TuanAnhPham8459/SmartFarm/system/ceng355wk05hardwareconnstatus.md

# CENG 355 Week 05 Hardware Connectivity Status
## Weekly checks for every student:
- Present in person in a safe manner for the duration of the class: glasses, no food/drink, etc.
- Hardware and any other project equipment present.
## Last week
- Feedback:   
## This week
- Working on status update [wk05connectivity.md](wk05connectivity.md) by student D on behalf of the group due the night before 10am Sunday.
- Mention which of your sensors/effectors have built in I2C bus pull-up resistors and whether they can be easily disconnected.
- Insert Executive Summary from proposal into [ceng355report.md](ceng355report.md).
- Preparing App preferably on an actual phone for the demo, test with firebase.
- Test your sensor demos, we'll be working on a couple of projects that require updated PCBs in KiCad.
## Interim Demonstration week
Next week if your section falls on a Monday
