TuanAnhPham8459/SmartFarm/system/wk02hardware.md

# Hardware Status Update
## Recent and current progress
- **VEML7700 (1/A)**: Verified the sensor's functions and tested the other options/output it offers.
- **OPT4048 (2/B)**: Tested, working as expected.
- **SSD1305 (3/C)**: Tested, working as expected.
- **SGP40 (4/D)**: Continued diagnosing the inconsistency of this sensor.
- **ID-12LA (5/D)**: Tested, working as expected.
## Problems and hyperlinks/urls to potential solutions
- SGP40: The Raspberry Pi sometimes fails to recognize the sensor even after the recommended warm-up period.
- VEML7700: The settings function returns an error when used  - [Check official library document to find updated function](https://docs.circuitpython.org/projects/veml7700/en/latest/api.html)
## Financial
### Expenditures since previous report
Safety Glasses (4 pairs) - 27.07$
### Planned future expenses
New sensors are proposed but no costs have been incurred at this moment.
