TuanAnhPham8459/SmartFarm/system/355criticalpath2026sep-dec.md

# Welcome to [CENG 355 – Computer Systems Project](https://humber.ca/transferoptions/course-outlines/outline.html?code=CENG%20355)
https://www.humber.ca/careeradvancement/careerconnect-job-search-site   
https://humber.ca/advancementandalumni/scholarships-awards.html   
https://github.com/PrototypeZone/ceng317/blob/main/README.md   

# Critical Path

## Fall 2026 Class Schedule (Tentative)

|Week|B |A |Topics/Assignment | Due % |
|----|---|---|---|---|
| |2026-09-07|2026-09-07|Monday Public Holiday (Labour Day) - College Closed | |
|1 |2026-09-10|2026-09-11|Course Introduction and Schedule, [Group Setup, Group Project Proposal](ceng355wk01proposal.md) |1 First Class Sheet  |
|2 |2026-09-17|2026-09-18|Hardware status by student A, firmware, KiCad |4 Proposal |
|3 |2026-09-24|2026-09-25|Mobile status report by student B, |5 Hardware Status |
|4 |2026-10-01|2026-10-02|Database status report by student C, declaration of authorship, laser cutting Inkscape |5 Mobile Status |
|5 |2026-10-08|2026-10-09|Hardware connectivity status report by student D |5 Database Status |
| |2026-10-12|2026-10-12|Monday Public Holiday (Thanksgiving Day) - College Closed | |
|6 |2026-10-15|2026-10-16|Preliminary demos, troubleshooting |5 Connectivity Status|
|7 |2026-10-22|2026-10-23|Hardware/Firmware, Database, and Mobile App Independent Demonstration, all parts should work independently|10 Demo |
| |2026-10-29|2026-10-30|*Reading Week, No Class Scheduled* | |
|8 |2026-11-05|2026-11-06|Poster Draft, unit and production testing (Nov 6 Midterm Grades Due) |5 |
|9 |2026-11-12|2026-11-13|Enclosure and integration status |5 |
|10  |2026-11-19|2026-11-20|Presentation Slides due and poster updates |5 |
|11  |2026-11-26|2026-11-27|Troubleshooting, preliminary demonstrations |5 |
|12  |2026-12-03|2026-12-04|, Project Demonstration Group Final Presentation |5, 15 |
|~15~|2026-12-04|2026-12-04|Capstone Showcase (Mandatory attendance, your other professors will be advised to not schedule conflicting evaluations|20 |
| | | |The 2026 Winter Capstone Expo will take place on Friday, December 4th, from 1:00 to 4:00 p.m. | |
|13  |2026-12-10|2026-12-11|Report Checklist |5 |
|14  |2026-12-17|2026-12-18|Checklist feedback | |
| | | | |**100** |

• Students are reminded that they are working with prototypes and that
prototypes are not to be left powered unattended despite the connectivity that
they develop.

• The small physical prototypes that you build are to be safe enough to be
worked on at home and small enough to be carried with you.

• In alignment with the space below the tray in the Humber North Campus
Electronics Parts kit the overall project maximum dimensions are

12 13/16" x 5 ¹/₂" x 2 ³/₄" = 32.5cm x 14cm x 7cm.

• Keeping safety and Z462 in mind, the highest AC voltage that is to be used is
16Vrms from a wall adapter from which +/- 15V or as high as 45 VDC can be
obtained. Maximum power consumption is to be 20 Watts.

• If your PCB doesn’t work or you need to switch sensors/effectors, it is
recommended that you use the SparkFun Qwiic system:
[https://www.sparkfun.com/products/15945](https://www.sparkfun.com/products/15945)

• A passing grade for this course is 50%. To get an overall passing grade in
this course, students must independently pass the Reporting and the Project
Demonstration portions of the course. If one or more of these sections is less
than 50% then the final grade for the course will be the lower of the two marks.

• Late Submission penalty: 10% penalty per day for late submissions.

• Classroom attendance is mandatory for grading, the student will get zero for
the submission if they missed the session for the corresponding week.
