TuanAnhPham8459/SmartFarm/system/ceng355wk06midtermdemo.md

# CENG 355 Week 06

## Weekly checks for every student:
- [ ] Present in person in a safe manner for the duration of the class: glasses, no food/drink, etc.
- [ ] Hardware and any other project equipment present.

## Last week
- Feedback:   

## This week
- Preliminary Demos (still have next week unless your section falls on a Monday)   

## Demo
- Hardware/Firmware, Database, and Mobile App Independent Demonstration, all parts should work independently.
- [ ] PCB
- [ ] Case
- [ ] App 
- [ ] Database 
- [ ] Sensor/effector A value read/commanded  
- [ ] Sensor/effector B value read/commanded
- [ ] Sensor/effector C value read/commanded
- [ ] Sensor/effector D value read/commanded

## Next week, depending on the semester, could be a holiday (college closed) followed by reading week (college open) the subsequent week
- Some groups have priority work to do with their PCBs, KiCad.
- Many groups should continue to incrementally improve their case.
- All groups have integration work to do.
