TuanAnhPham8459/SmartFarm/system/wk03mobile.md

# Mobile Status Update
## Recent and current progress
- Merging code and connecting the sensors.
- How the app works: The app monitors sensor readings through a Firebase database and sends alerts when issues are detected. It also supports multiple farms under a single account, allowing users to monitor multiple farms from one account.
 
## Problems and hyperlinks/urls to potential solutions
OPT4048:
- Library was not set up - [Check library document on GitHub to find updated function](https://github.com/sparkfun/qwiic_opt4048_py)
- Missing module - [Check module document on GitHub to find updated function](https://github.com/adafruit/Adafruit_CircuitPython_OPT4048)
- Troubleshoot the sensor; replace it if the issue cannot be resolved within the available timeframe.

SSD1305 OLED:
- Environment was not set up - [Check official library document to find updated installation and dependencies](https://docs.circuitpython.org/projects/ssd1305/en/latest)

## Financial
### Expenditures since previous report
None.
### Planned future expenses
New sensors are proposed, but no costs have been incurred at this moment.
