TuanAnhPham8459/SmartFarm/system/wk04database.md

# Database Status Update
## Recent and current progress
* Case was redesigned base on instructor's feedback.
* New sensor was added to the scope to replace bad one: Air quality sensor [BME688](https://www.amazon.ca/Environmental-Multi-Function-Capability-Temperature-Atmospheric/dp/B0GF231DPN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).
* Currently the database is fetching realtime sensor data, alert, device's config, feedback, and user account. Further discussion about what should be next to be sent to database is ongoing.
* Fetches sensor logs with configurable limits and sorts by timestamp descending.
* Links database documents directly to authenticated user IDs and email/password or Google sign-in credentials.
* Leverages Firestore's built-in offline persistence and cache metadata checks. Caches user profile data locally so the app remains usable when offline.
## Problems and hyperlinks/urls to potential solutions
Daisy chained sensors will not work if keeping the SenseHat. Since we use all kind of sensors, SenseHat is redundant and can be removed.
## Financial
### Expenditures since previous report
New air sensor BME688: 25$
### Planned future expenses
Bolt and nut
