TuanAnhPham8459/SmartFarm/hardware/Final Report - Tuan Anh Pham.docx

Hardware Report / Build Instructions

Multithreaded Raspberry Pi Monitoring System

SSD1305 OLED • Sense HAT • GPIO17 Transistor-Driven LED

Report item | Information
Platform | Raspberry Pi 4 running Raspberry Pi OS
Application | Real-time system, environment, orientation, and network monitoring
Target reader | Computer Engineering Technology student reproducing the project
Prepared for | CENG317 Hardware Project
Date | August 2026

Document purpose

This document provides the hardware, platform configuration, assembly, software installation, operation, and testing procedures required to reproduce the project. All GPIO changes must be performed while the Raspberry Pi is shut down and disconnected from power.

# Table of Contents

Section | Contents
1.0 | Introduction: Raspberry Pi Platform and Existing Functionality
1.1 | Scope and expected result
1.2 | Safety and handling requirements
2.0 | Added Functionality and System Architecture
2.1 | Sensor/Effector Purchase and Preparation
2.1.1 | Required tools
2.2 | PCB Design and Soldering
2.2.1 | Circuit function
2.2.2 | PCB inspection before soldering
2.2.3 | Recommended soldering order
2.2.4 | Unpowered electrical tests
2.3 | Case Design and Assembly
2.3.1 | Mechanical arrangement
2.3.2 | Assembly sequence
2.3.3 | Signal assignment
2.4 | Firmware Development and Use
2.4.1–2.4.3 | Platform, I²C, and Python environment configuration
2.4.4–2.4.8 | Application architecture, device operation, and execution
3.0 | Testing and Results
3.1–3.6 | Test sequence, standalone tests, results, troubleshooting, and acceptance
4.0 | References
Appendix A | Key Configuration Values
Appendix B | Command Summary

# 1.0 Introduction: Raspberry Pi Platform and Existing Functionality

The project is based on a Raspberry Pi 4 single-board computer using the Broadcom system-on-chip platform and the 40-pin general-purpose input/output (GPIO) header. Raspberry Pi OS provides Linux process management, device drivers, I²C communication, network services, thermal information, and Python support. These built-in capabilities make the platform suitable for combining system monitoring with environmental sensing and physical status indication.

The completed device monitors processor utilization, memory utilization, processor temperature, system uptime, local Internet Protocol (IP) address, external network availability, ambient temperature, relative humidity, atmospheric pressure, pitch, roll, and yaw. A 128 × 32 SSD1305 organic light-emitting diode (OLED) presents detailed values. A Raspberry Pi Sense HAT supplies environmental and orientation measurements, joystick input, and an 8 × 8 red-green-blue (RGB) matrix. A custom printed circuit board (PCB) uses GPIO17 and a 2N3904 NPN transistor to drive an external light-emitting diode (LED).

Three worker threads operate concurrently. The OLED thread formats and refreshes status pages. The Sense HAT thread reads sensors, receives joystick events, and controls the RGB matrix. The PCB LED thread toggles GPIO17 independently. A main thread starts the workers, provides a common stop event, and performs orderly shutdown. A locked shared-state object prevents inconsistent sensor values while the Sense HAT thread writes data and the OLED thread reads it.

## 1.1 Scope and expected result

- Configure Raspberry Pi OS, I²C, Python, and the project virtual environment.
- Assemble the Sense HAT, SSD1305 OLED, and transistor-driven LED PCB without GPIO conflicts or shorts.
- Install and run the multithreaded Python application.
- Verify every hardware device independently before running the combined application.
- Demonstrate concurrent operation, joystick control, sensor acquisition, and safe cleanup.

The procedure assumes a Raspberry Pi 4 with a working microSD card, network connection, display or Secure Shell (SSH) access, and a regulated USB-C power supply rated appropriately for the Raspberry Pi 4 and attached accessories.

## 1.2 Safety and handling requirements

WARNING: Never attach, remove, or reposition a HAT, Bonnet, PCB, jumper wire, or GPIO connector while the Raspberry Pi is powered. A one-pin offset or partially seated connector can short 3.3 V, 5 V, and ground.

- Shut down with sudo shutdown -h now, wait for activity to stop, and unplug USB-C power before hardware changes.
- Use nylon standoffs. Conductive spacers or screws must not contact solder joints, pads, or traces.
- Seat every 40-pin connector fully and evenly. Spacers must support the board without pulling the connector upward.
- Use 3.3 V GPIO logic. No Raspberry Pi GPIO pin is 5 V tolerant.
- Drive the external LED through the PCB transistor circuit; do not connect a high-current load directly to GPIO17.

# 2.0 Added Functionality and System Architecture

The added hardware extends the Raspberry Pi from a general-purpose Linux computer into a self-contained monitoring station. The functional allocation is shown below.

Subsystem | Primary function | Interface/resource
SSD1305 OLED | Displays system, environmental, orientation, and network pages | I²C bus 1; address 0x3C; GPIO4 reset
Sense HAT V2 | Measures environment and orientation; receives joystick input; shows status icon | 40-pin HAT connection; I²C and framebuffer/input drivers
Custom PCB LED driver | Provides an external one-second status blink | GPIO17, physical pin 11, through 2N3904 transistor
Python application | Coordinates devices using separate worker threads | threading.Event, threading.Lock, shared state

## 2.1 Sensor/Effector Purchase and Preparation

Table 1 lists the required materials. Equivalent parts may be substituted only when voltage, interface, dimensions, and pin functions are verified against the replacement datasheet.

Qty. | Item | Specification or selection requirement
1 | Raspberry Pi 4 | Any memory size; 40-pin GPIO header; Raspberry Pi OS support
1 | microSD card | 16 GB minimum; reliable Class 10 or better recommended
1 | USB-C power supply | Regulated supply suitable for Raspberry Pi 4 and accessories
1 | Adafruit 2.23-inch OLED Bonnet | 128 × 32 monochrome OLED; SSD1305; I²C address 0x3C; GPIO4 reset
1 | Raspberry Pi Sense HAT V2 | Environmental sensors, inertial measurement unit, joystick, 8 × 8 RGB matrix
1 | Custom LED PCB | 2N3904 NPN transistor driver connected to GPIO17
1 | External LED and resistor | Installed according to the custom PCB schematic and LED polarity
1 | 40-pin stacking header or GPIO duplicator | Must allow both boards to connect fully without mechanical interference
4+ | Nylon standoffs, screws, and nuts | Correct height for the board stack; nonconductive
As needed | Insulated jumper wires/connectors | Short, secure connections; labelled for 3.3 V, GND, SDA, SCL, and reset

### 2.1.1 Required tools

- Digital multimeter with direct-current voltage, resistance, and continuity modes.
- Temperature-controlled soldering iron, solder, flux, tip cleaner, and desoldering braid or pump.
- Small side cutters, needle-nose pliers, wire stripper, and precision screwdriver set.
- ESD-safe work surface or grounded antistatic precautions.
- Computer or Raspberry Pi terminal for operating-system imaging, package installation, and testing.

## 2.2 PCB Design and Soldering

### 2.2.1 Circuit function

GPIO17 supplies only the transistor control signal. When GPIO17 is HIGH, base current turns the 2N3904 on and current flows through the LED load path. When GPIO17 is LOW, the transistor turns off and the LED current stops. The base resistor, LED current-limiting resistor, transistor pinout, supply rail, and common ground must match the project schematic.

Pinout check: The 2N3904 emitter, base, and collector order must be verified for the exact manufacturer part. Do not rely only on the flat side of the package because lead ordering can vary by package and vendor.

### 2.2.2 PCB inspection before soldering

Step 1 — Identify pin 1 and connector orientation

Locate physical pin 1 on the Raspberry Pi header footprint and confirm that the footprint was not mirrored when placed on the underside of the PCB. Mark pin 1 temporarily with removable tape.

Step 2 — Trace the required nets

Using the schematic and PCB viewer, verify 3.3 V, ground, SDA, SCL, GPIO4 reset, and GPIO17. Confirm that the OLED VCC connector is connected to Raspberry Pi physical pin 1 or 17 and that OLED ground connects to a valid ground pin.

Step 3 — Check clearances

Confirm that mounting holes, connector bodies, solder joints, and standoffs do not interfere with the Sense HAT or OLED. Confirm access to the joystick and visibility of both displays.

### 2.2.3 Recommended soldering order

Step 1 — Install low-profile resistors

Insert and solder the transistor base resistor and LED current-limiting resistor. Trim leads close to the solder joint without damaging the pad.

Step 2 — Install the 2N3904

Orient the transistor according to the verified emitter-base-collector mapping. Leave a small gap between the body and PCB to prevent mechanical stress.

Step 3 — Install the LED

Match the LED anode and cathode to the PCB markings. The cathode is normally identified by the shorter lead and the flat edge of the LED package.

Step 4 — Install headers and connectors

Hold headers perpendicular to the PCB while soldering one corner pin. Recheck alignment before soldering the remaining pins. Avoid excess solder that could bridge adjacent header pins.

Step 5 — Clean and inspect

Remove flux residue when required by the flux type. Inspect every joint under bright light for bridges, insufficient wetting, cracked rings, or untrimmed leads.

### 2.2.4 Unpowered electrical tests

Disconnect the Raspberry Pi and all power sources. Use continuity or resistance mode and record the results before assembly.

Measurement | Expected result | Action if incorrect
PCB pin 1/17 to OLED VCC | Continuity; near-zero wiring resistance | Repair missing trace, solder joint, or connector mapping
PCB ground to OLED GND | Continuity | Repair ground connection
GPIO2 to OLED SDA | Continuity | Correct SDA routing
GPIO3 to OLED SCL | Continuity | Correct SCL routing
GPIO4 to OLED reset | Continuity | Add or repair reset connection
GPIO17 to transistor base resistor | Continuity through the intended route | Correct GPIO17 trace or solder joint
3.3 V to ground | No steady near-zero resistance | Locate short before applying power
5 V to ground | No steady near-zero resistance | Locate short before applying power

## 2.3 Case Design and Assembly

### 2.3.1 Mechanical arrangement

Both the Sense HAT and OLED Bonnet require Raspberry Pi signals, but both cannot occupy the same physical header position without a stacking arrangement. Use a proper 40-pin stacking header, GPIO duplicator, or ribbon-cable breakout. The connector must be fully seated; taller nylon spacers must not be used to hold a connector partly disengaged.

Layer | Assembly requirement
Top/user-access layer | Sense HAT joystick and RGB matrix must remain unobstructed.
OLED location | Screen must remain visible; GPIO4 reset and I²C signals must be routed correctly.
Custom PCB | No exposed conductor may touch either HAT; GPIO17 LED circuit must remain accessible.
Raspberry Pi 4 | USB-C power, HDMI, network, and ventilation openings must remain accessible.
Standoffs | Use nylon hardware of matching height at all supported corners.

### 2.3.2 Assembly sequence

Step 1 — Shut down and isolate power

Run sudo shutdown -h now. Wait until storage activity stops, then disconnect the USB-C supply and every externally powered cable.

Step 2 — Install Raspberry Pi standoffs

Fasten nylon standoffs without overtightening. Confirm that the board remains flat and that no fastener contacts components.

Step 3 — Connect the custom PCB

Align physical pin 1, engage both GPIO rows evenly, and press only on the connector area. Confirm that the board is level and fully seated.

Step 4 — Connect the OLED

Route 3.3 V, ground, SDA, SCL, and GPIO4 reset. Follow signal labels rather than wire colour because jumper colours are not standardized.

Step 5 — Connect the Sense HAT

Align the complete 40-pin connector with the duplicator or stacking header. Confirm that neither row is offset and that the joystick remains accessible.

Step 6 — Perform final inspection

Check for bent pins, loose wires, metal contact, reversed connectors, and insufficient clearance. Verify that the stack cannot rock or pull upward from the header.

Step 7 — Apply power

Connect the regulated Raspberry Pi power supply. If all LEDs immediately go dark, power cycles repeatedly, a component heats rapidly, or an unusual smell is detected, disconnect power and repeat short-circuit tests.

### 2.3.3 Signal assignment

Signal/device | BCM GPIO | Physical pin | Purpose
3.3 V | — | 1 or 17 | OLED/logic supply as required by the assembly
Ground | — | 6 or another GND | Common electrical reference
I²C SDA | GPIO2 | 3 | OLED and I²C sensor data
I²C SCL | GPIO3 | 5 | OLED and I²C sensor clock
OLED reset | GPIO4 | 7 | Places SSD1305 controller in a known startup state
PCB LED control | GPIO17 | 11 | Drives 2N3904 base circuit

## 2.4 Firmware Development and Use

### 2.4.1 Raspberry Pi OS preparation

Step 1 — Install Raspberry Pi OS

Use Raspberry Pi Imager to write Raspberry Pi OS to the microSD card. Configure the hostname, user account, network, locale, and SSH settings as required. Insert the card and boot the Raspberry Pi.

Step 2 — Update the operating system

Open a Linux terminal and update package information before installing hardware libraries.

sudo apt update

sudo apt full-upgrade -y

Step 3 — Enable I²C

Run the configuration utility, select Interface Options → I2C → Enable, finish, and reboot.

sudo raspi-config

sudo reboot

Step 4 — Install diagnostic and Python packages

Install the I²C scanner, virtual-environment support, Pillow, psutil, and official Sense HAT software.

sudo apt install -y i2c-tools python3-pip python3-venv python3-pil python3-psutil sense-hat

Step 5 — Reboot after Sense HAT installation

The reboot loads the required kernel drivers and device-tree configuration.

sudo reboot

### 2.4.2 Verify I²C hardware

After rebooting, scan bus 1. The OLED should normally appear at hexadecimal address 3c. Additional addresses may appear for the Sense HAT. An empty scan indicates a wiring, power, connector, or interface problem and must be corrected before running the application.

ls -l /dev/i2c-1

sudo i2cdetect -y 1

### 2.4.3 Create and configure the Python environment

A project-specific virtual environment prevents package conflicts. The commands below assume that the project folder is /home/pi/CENG317.

mkdir -p ~/CENG317

cd ~/CENG317

python3 -m venv oled-env

source oled-env/bin/activate

python -m pip install --upgrade pip setuptools wheel

python -m pip install adafruit-blinka adafruit-circuitpython-ssd1305 pillow psutil RPi.GPIO

The terminal prompt should begin with (oled-env). Verify all required imports before running the project:

python -c "import board, adafruit_ssd1305, psutil, RPi.GPIO; from PIL import Image; from sense_hat import SenseHat; print('Libraries ready')"

Thonny configuration: Shell commands such as cd and source must not be entered at the >>> Python prompt. In Thonny, select Tools → Options → Interpreter → Alternative Python 3 interpreter or virtual environment, then choose /home/pi/CENG317/oled-env/bin/python and restart the backend.

### 2.4.4 Multithreaded application structure

Copy dual_oled_sensehat_dashboard.py into ~/CENG317. The program allocates one owner thread per hardware subsystem. This separation prevents the one-second LED timing from blocking joystick events, sensor acquisition, or OLED refreshes.

oled_thread = threading.Thread(

target=oled_worker, args=(state, stop_event), name="OLED-Thread")

sense_thread = threading.Thread(

target=sense_hat_worker, args=(state, stop_event), name="SenseHAT-Thread")

pcb_led_thread = threading.Thread(

target=pcb_led_worker, args=(stop_event,), name="PCB-LED-Thread")

oled_thread.start()

sense_thread.start()

pcb_led_thread.start()

The Sense HAT thread writes environmental and orientation values to SharedState. The OLED thread reads the same values. A threading.Lock provides mutual exclusion so a complete set of readings is copied consistently.

with state.lock:

state.temperature = adjusted_temperature

state.humidity = humidity

state.pressure = pressure

with state.lock:

temperature = state.temperature

humidity = state.humidity

pressure = state.pressure

A threading.Event provides a shared shutdown signal. Ctrl+C sets the event; every thread leaves its loop, clears its hardware, and releases GPIO resources.

### 2.4.5 OLED operation

The OLED thread initializes a 128 × 32 SSD1305 at address 0x3C and uses GPIO4 for reset. Pillow creates a one-bit image in memory. The page title and two compact lines are drawn and transferred to the OLED buffer. Four pages rotate automatically:

- PI SYSTEM: CPU utilization, RAM utilization, processor temperature, and uptime.
- ENVIRONMENT: adjusted Sense HAT temperature, humidity, and pressure.
- ORIENTATION: pitch, roll, and yaw in degrees.
- NETWORK: local IP address and online/offline state.

oled = adafruit_ssd1305.SSD1305_I2C(

128, 32, i2c, addr=0x3C, reset=reset_pin)

image = Image.new("1", (128, 32))

oled.image(image)

oled.show()

### 2.4.6 Sense HAT and joystick operation

The Sense HAT thread reads temperature, humidity, pressure, and orientation approximately twice per second. Pitch represents front-to-back tilt, roll represents side-to-side tilt, and yaw represents rotation about the vertical axis. The RGB matrix displays a green check when the network test succeeds and a red X when it fails.

Joystick action | Application response
Right | Select next OLED page and disable automatic rotation
Left | Select previous OLED page and disable automatic rotation
Centre press | Toggle automatic page rotation
Up | Increase Sense HAT matrix brightness
Down | Decrease brightness; level zero clears the matrix

### 2.4.7 PCB LED operation

The LED worker configures BCM GPIO17 as an output and alternates HIGH and LOW once per second. stop_event.wait() is used instead of sleep(), allowing immediate interruption during shutdown. The cleanup block forces GPIO17 LOW before releasing the channel.

while not stop_event.is_set():

GPIO.output(PCB_LED_PIN, GPIO.HIGH)

if stop_event.wait(1.0):

break

GPIO.output(PCB_LED_PIN, GPIO.LOW)

if stop_event.wait(1.0):

break

### 2.4.8 Run and stop the program

cd ~/CENG317

source oled-env/bin/activate

python dual_oled_sensehat_dashboard.py

The terminal should report that all three threads started. Stop the application with Ctrl+C. Normal shutdown clears the OLED and Sense HAT matrix, turns the PCB LED off, cleans GPIO17, and joins all worker threads.

# 3.0 Testing and Results

## 3.1 Test sequence

Each subsystem must pass independently before the combined test. This isolates wiring and dependency problems and prevents one thread failure from being mistaken for a complete system failure.

Test | Procedure | Pass criterion
Power rail | Measure OLED VCC to GND after power-up. | Approximately 3.3 V; no rapid heating or power cycling.
I²C scan | Run sudo i2cdetect -y 1. | OLED appears at 0x3C; Sense HAT addresses also appear.
OLED standalone | Initialize SSD1305, fill the display, then show text. | Screen illuminates and displays stable text without stripes.
Sense HAT sensors | Print temperature, humidity, pressure, pitch, roll, and yaw. | Plausible values update; orientation changes when moved.
RGB matrix | Display red, green, and blue for two seconds each. | All matrix pixels show the requested colours.
Joystick | Press all five directions. | Correct direction events are received.
PCB LED | Run the GPIO17 blink worker. | External LED alternates on/off once per second.
Combined application | Run all three threads for at least two minutes. | OLED refreshes, joystick responds, matrix indicates network status, and LED blinks concurrently.
Shutdown | Press Ctrl+C. | Displays clear, LED turns off, GPIO cleans up, and process exits.

## 3.2 Standalone OLED test

import time, board, busio, digitalio, adafruit_ssd1305

reset = digitalio.DigitalInOut(board.D4)

i2c = busio.I2C(board.SCL, board.SDA)

oled = adafruit_ssd1305.SSD1305_I2C(128, 32, i2c, addr=0x3C, reset=reset)

oled.fill(1); oled.show(); time.sleep(2)

oled.fill(0); oled.text("OLED WORKING", 20, 12, 1); oled.show()

time.sleep(5)

oled.fill(0); oled.show()

## 3.3 Standalone Sense HAT matrix test

from sense_hat import SenseHat

from time import sleep

sense = SenseHat()

for colour in [(255,0,0), (0,255,0), (0,0,255)]:

sense.clear(*colour)

sleep(2)

sense.clear()

## 3.4 Expected combined results

- The OLED changes among four information pages automatically every five seconds unless manual navigation disables automatic rotation.
- The joystick changes pages and matrix brightness without interrupting the PCB LED timing.
- System values refresh approximately every 0.5 seconds and environmental/orientation readings are supplied by the Sense HAT thread.
- The RGB matrix shows network state while the OLED provides the IP address and text status.
- The GPIO17 LED continues blinking even while OLED pages change or orientation values are updated.
- Ctrl+C ends all threads and leaves every output in an off state.

## 3.5 Troubleshooting guide

Symptom | Likely cause | Corrective action
i2cdetect shows no devices | No OLED power, SDA/SCL error, disabled I²C, loose connector, or damaged module | Measure VCC; verify pins 1/6/3/5; enable I²C; replace jumpers; bypass PCB for direct test.
No device at 0x3C / errno 121 | OLED does not acknowledge address | Confirm 0x3C in i2cdetect before changing code; check power, reset, and I²C routing.
Striped or scrambled OLED | Wrong controller/height or missing reset | Use adafruit_ssd1305, 128 × 32 geometry, and GPIO4 reset.
No module named board | Adafruit Blinka absent from active interpreter | Activate oled-env and install adafruit-blinka.
No module named adafruit_ssd1305 | SSD1305 library absent or Thonny using wrong interpreter | Install adafruit-circuitpython-ssd1305 in oled-env and select oled-env/bin/python in Thonny.
psutil is not defined | Missing import | Add import psutil near the top of the program.
Sense HAT works but OLED is blank | OLED worker failed independently | Read terminal message beginning OLED thread error; test OLED alone.
Matrix is blank | Brightness level is zero or worker error | Press joystick up; run standalone colour test; inspect Sense HAT thread error.
Entire system loses power | Misaligned/partial connector or short | Disconnect immediately; remove accessories; test Pi alone; perform unpowered resistance checks.
pip reports certificate verification failure | Incorrect clock or stale CA certificates | Correct system time; reinstall ca-certificates; avoid insecure certificate bypasses.

## 3.6 Final acceptance checklist

- ☐ All 40-pin connectors are fully seated, aligned, and mechanically supported.
- ☐ No steady short exists between 3.3 V and ground or between 5 V and ground.
- ☐ OLED address 0x3C appears on I²C bus 1.
- ☐ OLED, Sense HAT, joystick, RGB matrix, and PCB LED pass standalone tests.
- ☐ All three worker threads start and remain active during the combined test.
- ☐ Shared readings remain plausible while the OLED pages update.
- ☐ Joystick controls match the documented direction mapping.
- ☐ Ctrl+C produces clean shutdown with all visible outputs off.

# 4.0 References

[1] Adafruit Industries, “Adafruit 2.23-inch Monochrome OLED Bonnet: Usage,” accessed August 2026. https://learn.adafruit.com/adafruit-2-23-monochrome-oled-bonnet/usage

[2] Raspberry Pi Ltd., “Sense HAT Documentation,” accessed August 2026. https://www.raspberrypi.com/documentation/accessories/sense-hat.html

[3] Raspberry Pi Ltd., “Raspberry Pi Computer Hardware and GPIO Documentation,” accessed August 2026. https://www.raspberrypi.com/documentation/computers/raspberry-pi.html

[4] Adafruit Industries, “Adafruit CircuitPython SSD1305,” accessed August 2026. https://github.com/adafruit/Adafruit_CircuitPython_SSD1305

[5] psutil contributors, “psutil Documentation,” accessed August 2026. https://psutil.readthedocs.io/

[6] Ontario Association of Certified Engineering Technicians and Technologists, “Technology Report Guidelines,” revised June 2022. https://www.oacett.org/getmedia/5ad707d7-f472-4b24-a7fe-f34e270b0c41/2022_TR_Guidelines_-_Updated_Version_-_Sept_2022.pdf

# Appendix A — Key Configuration Values

Configuration item | Value
OLED controller | SSD1305
OLED geometry | 128 × 32 pixels
OLED I²C address | 0x3C
OLED reset | BCM GPIO4 / physical pin 7
PCB LED output | BCM GPIO17 / physical pin 11
OLED refresh interval | 0.5 s
Sense HAT refresh interval | 0.5 s
Automatic page interval | 5.0 s
PCB LED interval | 1.0 s on, 1.0 s off
Number of OLED pages | 4

# Appendix B — Command Summary

# Enable I2C

sudo raspi-config

# Install operating-system packages

sudo apt update

sudo apt install -y i2c-tools python3-pip python3-venv python3-pil python3-psutil sense-hat

# Verify I2C

sudo i2cdetect -y 1

# Activate environment

cd ~/CENG317

source oled-env/bin/activate

# Run application

python dual_oled_sensehat_dashboard.py

# Stop application

Ctrl+C

# Shut down before hardware changes

sudo shutdown -h now

Raspberry Pi Multithreaded Monitoring System — Build Instructions |
