TuanAnhPham8459/SmartFarm/hardware/Smart Farm - BoM.docx

Complete Bill Of Materials

Link to former rubric (https://github.com/PrototypeZone/hardwareproject-Ali-HumberLab2022/blob/main/hardware/bomrubric.md)

Group 8: Hoang Tran, Chau Vi Cuong Nguyen, Truong An Nguyen, Tuan Anh Pham

Please add your Sensor/Effector below and to myLists.xlsx (https://github.com/PrototypeZone/hardwareproject-Ali-HumberLab2022/blob/main/hardware/myLists.xlsx) to be used via https://www.digikey.ca/en/mylists/ for this semester's purchases. Clicking on the part should take the reader to the item on the intended vendor's website.

Part | Price in CAD | Quantity | Shipping Cost | Duty | Tax | Subtotal Paid | Subtotal propose to order | Expected Arrival Date
2N4124 PNP Transistor from Parts kit (https://www.onsemi.com/pdf/datasheet/2n4123-d.pdf) | 0.70 | 1 | | | | 0.70 | | Semester 1
5mm Red LED from Parts kit (https://www.bkstr.com/humberitstore/home) | 0.26 | 1 | | | | 0.26 | | Semester 1
220 Ohm Resistor from Parts kit (https://www.bkstr.com/humberitstore/home) | 0.02 | 1 | | | | 0.02 | | Semester 1
2.2 kOhm Resistor from Parts kit (https://www.bkstr.com/humberitstore/home) | 0.02 | 1 | | | | 0.02 | | Semester 1
Raspberry Pi Extreme Kit (https://www.canakit.com/raspberry-pi-4-extreme-kit.html) | 144.95 | 1 | | | | 144.95 | | Semester 2
SD card reader (https://www.digikey.ca/en/products/detail/sparkfun-electronics/COM-13004/6161756) | 7.91 | 1 | | | | 7.91 | | Semester 2
SenseHat (https://www.digikey.ca/en/products/detail/raspberry-pi/SENSE-HAT/6196429) | 43.16 | 1 | | | | 43.16 | | Semester 2
Network adapter (https://www.amazon.ca/Cable-Matters-SuperSpeed-Gigabit-Ethernet/dp/B00BBD7NFU) | 20.99 | 1 | | | | 20.99 | | Semester 2
Ethernet cable (https://www.amazon.ca/StarTech-com-Cat5e-Ethernet-Cable1-Snagless/dp/B0002XGHBQ) | 9.49 | 1 | | | | 9.49 | | Semester 2
Sensor/Effector | TBD | 1 | | | TBD | | TBD | Reading Week
SGP 40 (https://www.digikey.com/en/products/detail/sparkfun-electronics/SEN-18345/14565027) | 30.42 | 1 | | | | | | June 2
VEML7700 (https://www.digikey.ca/en/products/detail/adafruit-industries-llc/4162/9997696) | 7.15 | 1 | | | | 7.15 | 7.15 | Reading Week
SSD1306 (https://www.digikey.com/en/products/detail/adafruit-industries-llc/3531/7364307) | 22.50 | 1 | | | | 22.50 | 22.50 | Reading Week
OPT4048DTSR (https://www.digikey.ca/en/products/detail/sparkfun-electronics/22638/21679199) | 20.79 | 1 | | | | 20.79 | 20.79 | Reading Week
Stacking Header (https://www.digikey.ca/en/products/detail/adafruit-industries-llc/1979/6238003) | 4.24 | 1 | | | 0.55 | | 4.79 | Reading Week
Grove socket (https://www.digikey.ca/en/products/detail/seeed-technology-co-ltd/110990037/5482561) | 2.45 | 1 | | | 0.32 | | 2.77 | Reading Week
Grove Cable (https://www.digikey.ca/en/products/detail/adafruit-industries-llc/4528/11627737) | 2.81 | 1 | | | 0.37 | | 3.18 | Reading Week
Qwiic Cable (https://www.digikey.ca/en/products/detail/sparkfun-electronics/CAB-22726/21443057) | 2.30 | 1 | | | 0.30 | | 2.60 | Reading Week
Qwiic Cable (https://www.digikey.ca/en/products/detail/adafruit-industries-llc/5384/16546428) | 1.80 | 1 | | | 0.23 | | 2.03 | Reading Week
16mm Standoff (https://www.digikey.ca/en/products/detail/w%C3%BCrth-elektronik/971160151/6174641) | 1.11 | 4 | | | 0.58 | | 5.02 | Reading Week
M2.5 Screw (https://www.digikey.ca/en/products/detail/essentra-components/50M025045I016/11638680) | 0.26 | 4 | | | 0.14 | | 1.18 | Reading Week
Safety glasses | 5.00 | 1 | | | 0.65 | | 5.65 | Week 0
Leadfree Solder (https://www.mouser.ca/ProductDetail/AIM/13949?qs=M7ZD%2F0QMIQw6T6JK0szTqg%3D%3D) | 96.11 | 0.02 | | | | 1.92 | | Week 0
PCB (https://github.com/PrototypeZone/ceng317/blob/main/hardware/pcb/PCBPrototypes.md) | 6.62 | 1 | | | | 6.62 | | Week 5
3mm Acrylic 12"x24" | 7.18 | 1 | | | | 7.18 | | Week 0
Laser Cutting (https://designandbuiltlabs.simplybook.me/v2/) | 1/min | TBD | | | | 1/min | | Week 7
3D Printing (https://sites.google.com/view/idealab3dprinting/tutorial) | 0.15/gram | TBD | | | | 0.15/gram | | Week 7
Assembly | 20/hour | TBD | | | | 20/hour | | Reading Week
Totals | | | | | | 243.22+ | <100.00
