TuanAnhPham8459/SmartFarm/hardware/SmartFarm_poster.pptx

SMART FARM Real-time greenhouse monitoring, alerts and control
Chau Vi Cuong Nguyen, Hoang Tran, Truong An Nguyen, Tuan Anh Pham | CENG 355 Capstone, Computer Engineering Technology, Humber Polytechnic


INTRODUCTION

- Problem Crop conditions change faster than a farmer can check.
- Solution Pi sensor node, cloud database, Android app.
- Result Live data, instant alerts, remote control.

SENSE
BME688, VEML7700, OPT4048, RFID on one I²C bus

PROCESS
Raspberry Pi + custom HAT, Python firmware

SYNC
Cloud Firestore over campus Wi-Fi, every 60 s

ACT
Android app: dashboard, alerts, controls

PCB ASSEMBLY

Custom Raspberry Pi HAT KiCad design, hand-soldered

Device | Measures | Address
BME688 (I²C) | Temp, humidity, pressure | 0x77
VEML7700 (I²C) | Ambient light | 0x10
OPT4048 (I²C) | Colour ( Green, Yellow, Red) | 0x44
ID-12LA (I²C) | Reading tag ID | 0x15
SSD1305 (I²C) | OLED display | 0x3C

Python firmware one thread per device

Cloud Firestore
sensor_data / device / readings

- Qwiic chain daisy-chains sensors with no extra wiring
- Sense HAT removed to free the I²C bus
- GPIO17 drives a status LED through a transistor switch

MOBILE APP RESULTS

Native Android app Java, Material design, minSdk 31

App architecture

UI Home, Analytics, Control Panel, Alerts

Controllers Login, Signup, Account ViewModel

Firestore managers Sensor, Device, Alert, User

Firebase Auth + Cloud Firestore, offline cache

Built with

DATABASE

- Live listeners push changes to the app
- Offline cache keeps the app usable without signal

sensor_data
readings: bme688, veml7700, opt4048, rfid

device_controls
pump, fan, light, autoMode


Schematic


Two-layer PCB layout

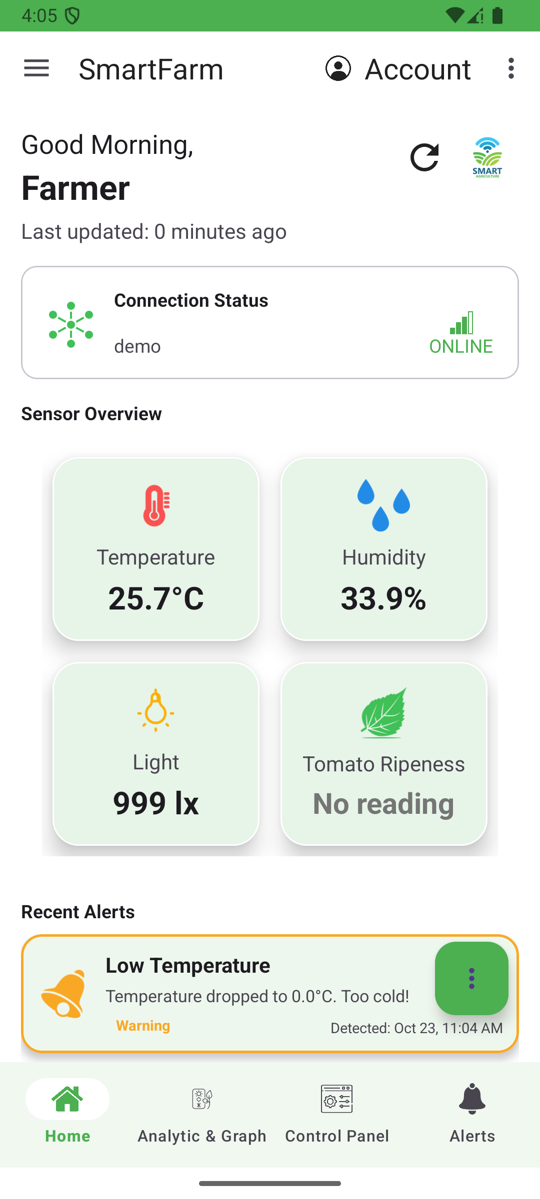
[picture p21: figure]

Dashboard

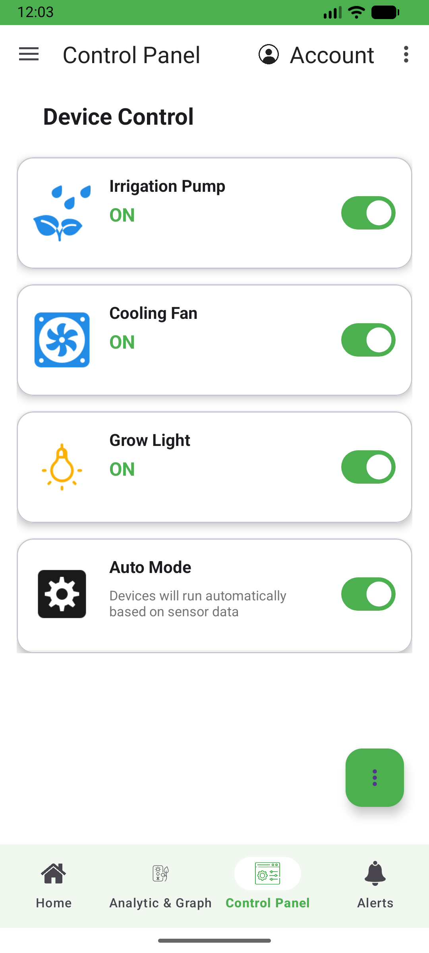
[picture p22: figure]

Control panel

1

alerts
history with Warning or Critical level

devices
one entry per farm device

2

3

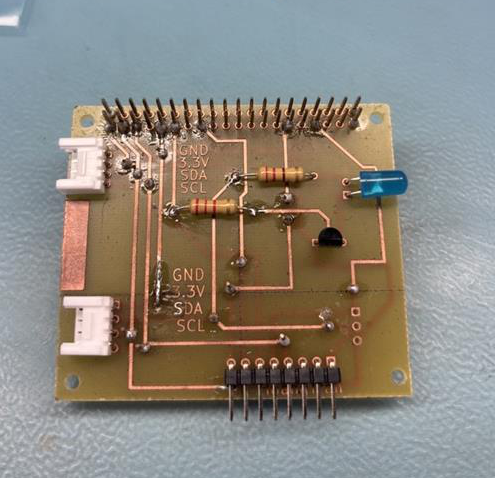
[picture p23: figure]

Assembled HAT

5
I²C devices, one bus

60 s
cloud upload interval

users
profile linked to Auth user ID

feedback
ratings + screen_tracking usage

4

Temperature

6
OLED status pages

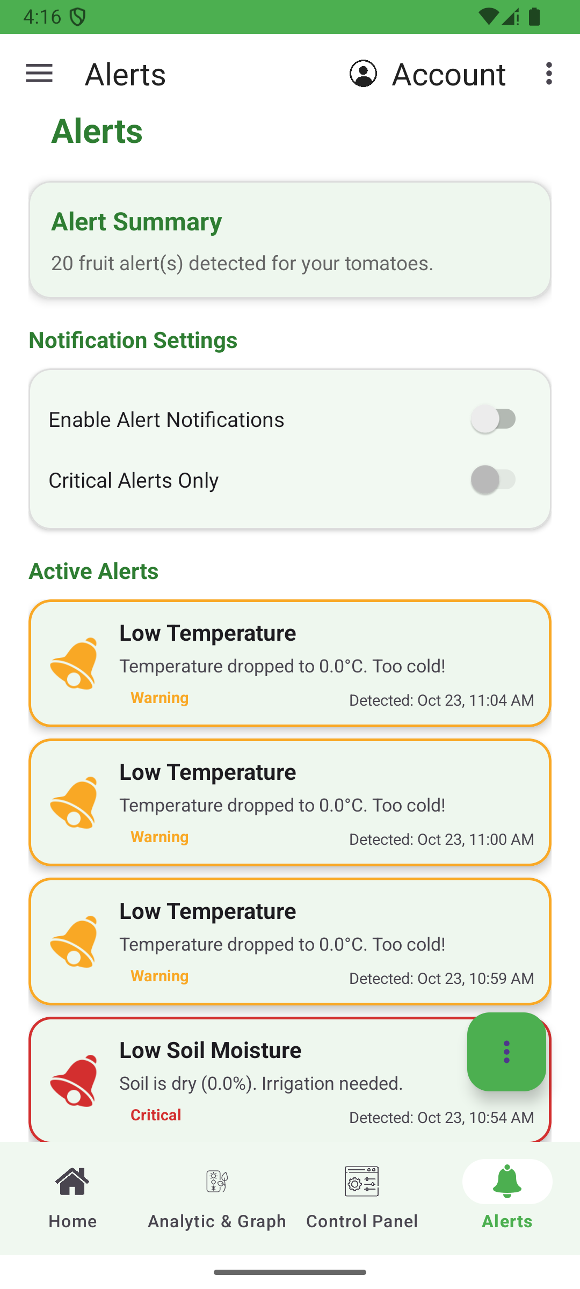
[picture p24: figure]

Alerts

History
min, max, average graphs

Humidity

Light

Fan

Irrigation

Accounts
email or Google, many farms

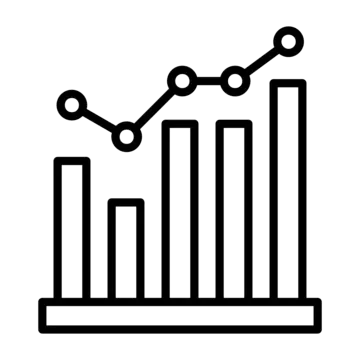
[picture p25: figure]

TESTING AND NEXT STEPS

101
automated tests
JUnit, Robolectric, Espresso

- Next: Pi acts on app controls (pump, fan)
- Next: fix OPT4048 colour accuracy
- Next: open beyond the Play closed test

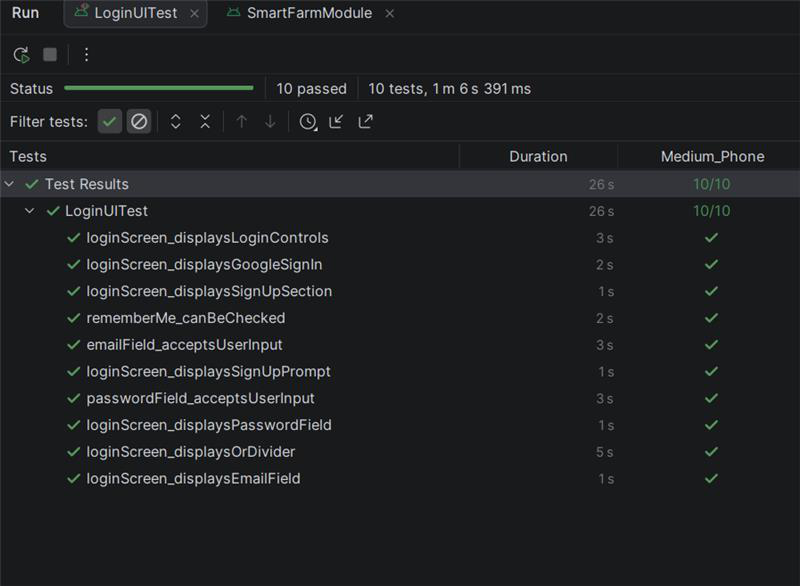
[picture p26: figure]

Espresso login tests: 10 / 10

ENCLOSURE DESIGN

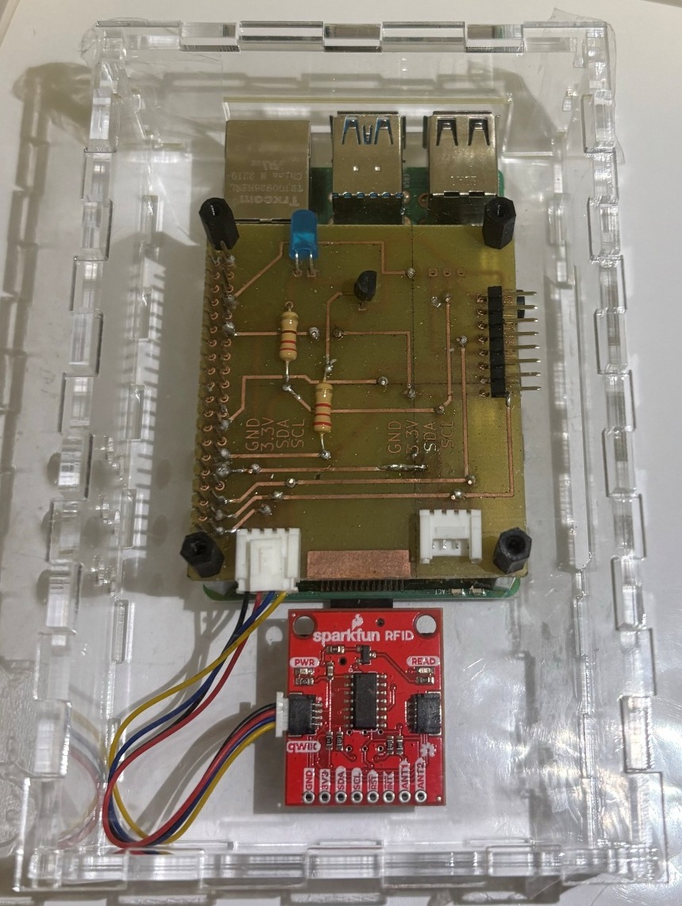
[picture p27: figure]

Pi + HAT + RFID reader in the case

20 W
max power

- Laser-cut clear acrylic
- Finger-joint tiles, no glue
- Open sides for Qwiic cables

Settings
°C/°F, theme, language

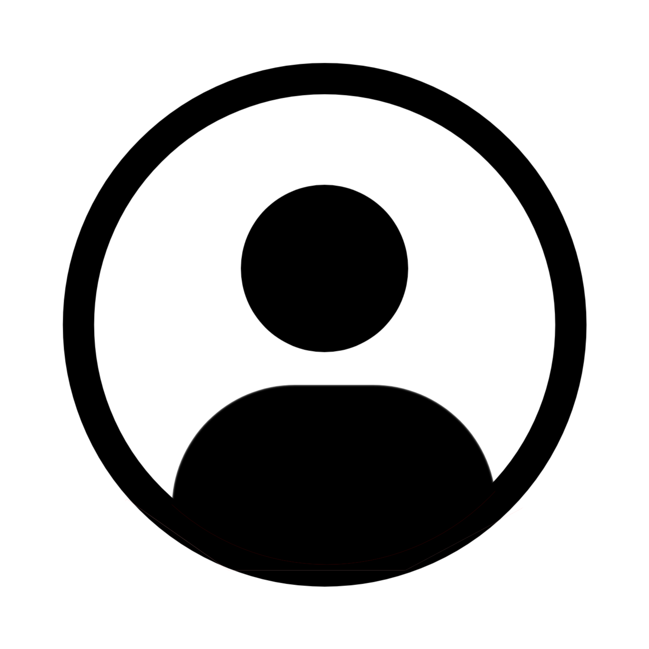
[picture p28: figure]

BME688

VEML7700

OPT4048

RFID

OLED

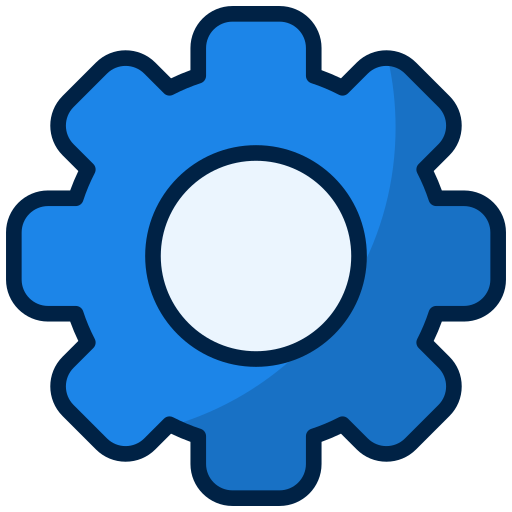
[picture p29: figure]

ACKNOWLEDGEMENTS

Kris Medri, Supervising Faculty

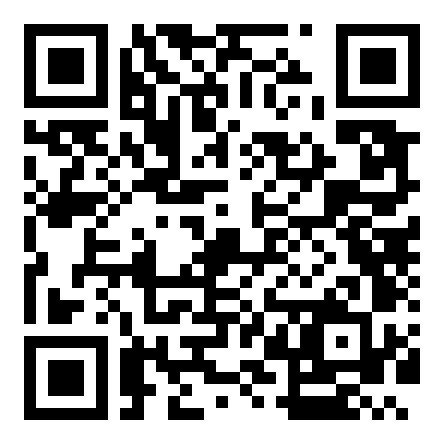
[picture p30: figure]
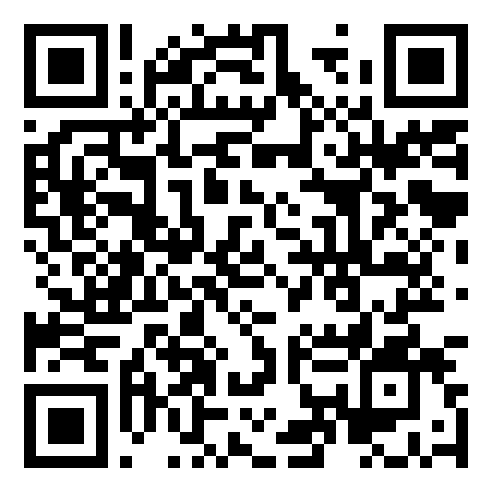
[picture p31: figure]

16 Vrms
max AC input

32.5 cm
max length

GitHub
source code

Google Play
closed test

Java

Material UI

MPAndroidChart

Google Play test

Notes: Section Start Slide
