TuanAnhPham8459/SmartFarm/hardware/Smart Farm - Roadmap.tsv

Title | Assignees | Status | Group 8 | Iteration | Start date | Target date | Quarter
Sensor selection/ propose idea for project |  |  |  |  | May 14, 2026 | May 21, 2026
Propose and order Materials List |  |  |  |  | May 21, 2026 | May 28, 2026
Design PCB |  |  |  |  | May 28, 2026 | Jun 4, 2026
Design hardware case |  |  |  |  | Jun 4, 2026 | Jun 17, 2026
Solder resistors on PCB or protoboard. |  |  |  |  | Jun 11, 2026 | Jun 25, 2026
Soldering Vias |  |  |  |  | Jun 18, 2026 | Jun 25, 2026
Enclosure, Soldering LED and transistor |  |  |  |  | Jun 25, 2026 | Jul 2, 2026
Ensure all parts arrive, catch up with soldering |  |  |  |  | Jul 2, 2026 | Jul 9, 2026
Coding firmware |  |  |  |  | Jul 9, 2026 | Jul 16, 2026
Assembling PCB |  |  |  |  | Jul 16, 2026 | Jul 23, 2026
PowerPoint preparation |  |  |  |  | Jul 23, 2026 | Jul 30, 2026
Troubleshooting |  |  |  |  | Jul 27, 2026 | Aug 3, 2026
Ensure the hardware functions properly for demo |  |  |  |  | Jul 29, 2026 | Aug 5, 2026
Prepare documentation and presentation |  |  |  |  | Jul 30, 2026 | Aug 13, 2026
Final report |  |  |  |  | Aug 13, 2026 | Aug 20, 2026
