TuanAnhPham8459/SmartFarm/system/ceng355report.md

# CENG 355 Project Name
Title Page (1st odd page not numbered, X.0 sections begin on odd pages, otherwise double sided and numbered)  
## Declaration of Joint Authorship   
This Technology Report was prepared as a group project by the following members:

- Chau Vi Cuong Nguyen
- Hoang Tran
- Truong An Nguyen
- Tuan Anh Pham

We confirm that the breakdown of authorship below represents our respective contributions to the work submitted for assessment. Each member's contribution is their own work and is expressed in their own words. Any use within this Technology Report of the work of authors outside the project group, including ideas, equations, figures, text, tables, programs, or other materials, is properly acknowledged at the point of use. A list of references used is included in this report. [^1]

### Group Contribution Breakdown

| Group Member | Primary Contribution | Percentage | Pages |
|---|---|---:|---:|
| Chau Vi Cuong Nguyen | Hardware Report / Firmware / Group Project Work | TBD | TBD |
| Truong An Nguyen | Hardware Report / Firmware / Group Project Work | TBD | TBD |
| Tuan Anh Pham | Hardware Report / Firmware / Group Project Work | TBD | TBD |
| Hoang Tran | Hardware Report / Firmware / Group Project Work | TBD | TBD |

The contribution percentages and page counts will be updated as the final
Technology Report is completed.

[^1]: Technology Report Guidelines. OACETT, Revised September 2022. Available at: https://www.oacett.org/getmedia/5ad707d7-f472-4b24-a7fe-f34e270b0c41/2022_TR_Guidelines_-_Updated_Version_-_Sept_2022.pdf
## Proposal/Project Specifications   
[Link to proposal](wk01proposal.md).   
## Executive Summary   
Smart Farm is an application that provides real-time environmental monitoring and automated alert systems for farming purpose. The app displays live sensor data (temperature, humidity, light, air quality, and color detection) received from a Raspberry Pi-based hardware system. It includes manual monitoring controls and triggers instant notifications when abnormal conditions are detected, helping farmers maintain a healthy environment remotely.    

## Table of Contents

[Declaration of Joint Authorship](#declaration-of-joint-authorship)   
[Proposal/Project Specifications](#proposalproject-specifications)   
[Executive Summary](#executive-summary)   
[Table of Contents](#table-of-contents)   
[List of Figures](#list-of-figures)   

[1.0 Introduction](#10-introduction)   
[1.1 Background](#11-background)   
[1.2 Project Requirements and Specifications](#12-project-requirements-and-specifications)   
[1.3 Project Schedule](#13-project-schedule)   

[2.0 Hardware Development Platform Report/Build Instructions](#20-hardware-development-platform-reportbuild-instructions)  
[2.1 Student One/A](#21-student-onea)  
[2.2 Student Two/B](#22-student-twob)  
[2.3 Student Three/C](#23-student-threec)  
[2.4 Student Four/D](#24-student-fourd)  

[3.0 Mobile Application Report](#30-mobile-application-report)  
[3.1 Deliverable 1](#31-deliverable-1)  
[3.2 Deliverable 2](#32-deliverable-2)  
[3.3 Deliverable 3](#33-deliverable-3)  
[3.4 Deliverable 4](#34-deliverable-4)  
[3.5 Deliverable 5](#35-deliverable-5)  

[4.0 Integration](#40-integration)  
[4.1 Enterprise Wireless Connectivity](#41-enterprise-wireless-connectivity)  
[4.2 Database Configuration](#42-database-configuration)  
[4.3 Network and Security Considerations](#43-network-and-security-considerations)  
[4.4 Unit Testing](#44-unit-testing)  
[4.5 Production Testing](#45-production-testing)  
[4.6 Sustainability Considerations](#46-sustainability-considerations)  
[4.7 Challenges/Problems](#47-challengesproblems)  
[4.8 Solutions](#48-solutions)  

[5.0 Results and Discussion](#50-results-and-discussion)

[6.0 Conclusions](#60-conclusions)

[7.0 Appendix](#70-appendix)  
[7.1 Firmware Code](#71-firmware-code)  
[7.2 Mobile Application Code](#72-mobile-application-code)  

[8.0 References](#80-references)  

## List of Figures   
[Figure 1: Gantt Chart]


## 1.0 Introduction   
### 1.1 Background   
### 1.2 Project Requirements and Specifications   
### 1.3 Project Schedule   
Insert Gantt Chart.     
###### Figure 1: Gantt Chart 


## 2.0 Hardware Development Platform Report/Build Instructions   
### 2.1 Student One/A
[Hardware report](</hardware/Final Report - Chau Vi Cuong Nguyen.docx>)   
### 2.2 Student Two/B   
[Hardware report](</hardware/Final Report - Truong An Nguyen.docx>)   
### 2.3 Student Three/C   
[Hardware report](</hardware/Final Report - Tuan Anh Pham.docx>)   
### 2.4 Student Four/D   
[Hardware report](</hardware/Final Report - Hoang Tran.docx>)   
  
## 3.0 Mobile Application Report   
### 3.1 Deliverable 1
[Mobile Deliverable 1](</docs/deliverable1/IoTInnovators - Deliverable 1.pdf>)   
### 3.2 Deliverable 2      
[Mobile Deliverable 2](</docs/deliverable2/IoTInnovators - Deliverable 2.pdf>)   
### 3.3 Deliverable 3      
[Mobile Deliverable 3](</docs/deliverable3/IoTInnovators - Deliverable 3.pdf>)   
### 3.4 Deliverable 4      
[Mobile Deliverable 4](</docs/deliverable4/IoTInnovators - Smart Farm - Deliverable 4.pdf>)   
### 3.4 Deliverable 5      
[Mobile Deliverable 5](</docs/deliverable5/IoTInnovators - Smart Farm - Deliverable 5.pdf>)   

## 4.0 Integration   
### 4.1 Enterprise Wireless Connectivity   
### 4.2 Database Configuration   
### 4.3 Network and Security Considerations   
### 4.4 Unit Testing   
### 4.5 Production Testing   
### 4.6 Sustainability Considerations
### 4.7 Challenges/Problems   
### 4.8 Solutions   

## 5.0 Results and Discussion   

## 6.0 Conclusions   

## 7.0 Appendix
### 7.1 Firmware Code   
[Link to firmware](https://github.com/ChauViCuongNguyen4611/SmartFarm/tree/master/hardware/firmware).
### 7.2 Mobile Application Code   
[Link to GitHub repository for app](https://github.com/ChauViCuongNguyen4611/SmartFarm)

## 8.0 References
