TuanAnhPham8459/SmartFarm/system/ceng355wk08posterdraft.md

# CENG 355 Week 08 Poster Draft

Remember that we are all on the figurative bus to the skills competition (job search) where, after completing 5.5 semesters, this is indeed where you belong and are able to say:
1. I belong in this academic community.
2. My ability and competence grow with my effort.
3. I can succeed at this.
4. This work has value for me.   
(Camille A. Farrington, 2012)

## Weekly checks for every student:
- [ ] Present in person in a safe manner for the duration of the class: glasses, no food/drink, etc.
- [ ] Hardware and any other project equipment present.
- Review/verify that:
  - [wk01proposal.md](wk01proposal.md) has accurate sensor/effector details and up to date design approach/system diagram.
  - [ceng355report.md](ceng355report.md#72-mobile-application-code) section 7.2 Mobile Application code has correct/functioning link.

## Poster hints and tips
Reuse text that you have from the proposal and other submissions as the basis of your poster content.
Be careful of spelling, punctuation and grammar. You are trying to impress your audience. The ability to write clearly and concisely is a key skill, especially in the technology space where jargon and acronyms are used generously. 

- **Summarise:** There is a temptation to present very dense text on presentations. Almost no one has the chance to read it all.   
- **Point form** bullet points - each point preferably one line, maximum two lines. The first 2-3 words of each bullet may act as header to convey the subject of the bullet. **Bold them** for emphasis.   
- **Legible** - choose a large enough font size. Should be comfortably readable by someone about 1-2m away.   
- **Diagrams** - a picture is worth a thousand words. A well thought out and briefly annotated diagram can vastly aid understanding.   
- **Tables** are good at presenting data 2-5 columns max, 5-8 rows max. Again resist the temptation for high density of information - less is more.  

## Poster Draft due 10am Sunday
/1 Present in person in a safe manner for the duration of the class: glasses, no food/drink, etc.   
/1 Hardware and any other project equipment present.   
/1 [Poster Template](wk08poster.pptx), upload updated wk08poster.pptx AND the equivalent wk08poster.pdf to repository. Example [GreenSense](https://github.com/ryanmcadie/GreenSense/blob/4c6248bee2d33b034694df6a5dcf572f0dbefccd/Presentations/GreenSensePoster.pptx.pdf).   
/1 Intro, H/W   
/1 Mobile and Integration   
- Unit testing -> consider testing each component separately.
- Production testing -> consider what you would test if a thousand came off an assembly line before sending them to customers.
- Sustainability -> consider where products are coming from, how they'll be used, end of product life and what materials the project contains along with indigenous values.

## Capstone Showcase
- For Winter 2024: Monday April 22nd in the BCTI -> [2019 Video on YouTube](https://www.youtube.com/watch?v=4B__Qo85ZoU)
- For Winter 2025: Wednesday April 23rd in the BCTI.   
- For Fall 2026: Friday, December 4th, from 1:00 to 4:00 p.m in the BCTI.
