TuanAnhPham8459/SmartFarm/docs/deliverable3/IoTInnovators - Deliverable 3.pdf

# CENG-322 Mobile Application Development -Deliverable 3

Team Name: IoT Innovators
Project Name: Smart Farm
Team Number: 8
Student’s names and IDs:
- Chau Vi Cuong Nguyen – N01634611
- Hoang Tran – N01613506
- Tuan Anh Pham – N01238459
- Truong Anh Nguyen - N01639800

## Table of Contents

2. Network State Permission (android.permission.ACCESS_NETWORK_STATE) ... 12

## Member Info and Participation

Name | Student ID | GitHub ID | Signature | Effort
Chau Vi Cuong Nguyen | N01634611 | ChauViCuongNguyen4611 | CVCN | 100
Hoang Tran | N01613506 | HoangTranTran3506 | HT | 100
Tuan Anh Pham | N01238459 | TuanAnhPham8459 | TA | 100
Truong An Nguyen | N01639800 | TruongAnNguyen9800 | TAN | 100

## Project Description

The Smart Farm IoT application aims to create a comprehensive mobile solution for modern farming management. The final vision is to provide farmers with real-time monitoring and control of IoT-enabled farm equipment, including temperature monitors, automated irrigation systems, and crop health trackers.

## GitHub Repo link

https://github.com/ChauViCuongNguyen4611/SmartFarm

## Login functionality

Email: aaa@bbb.com Password: Admin101!
Screenshot showing the Authentication and users logged in using gmail or their email accounts

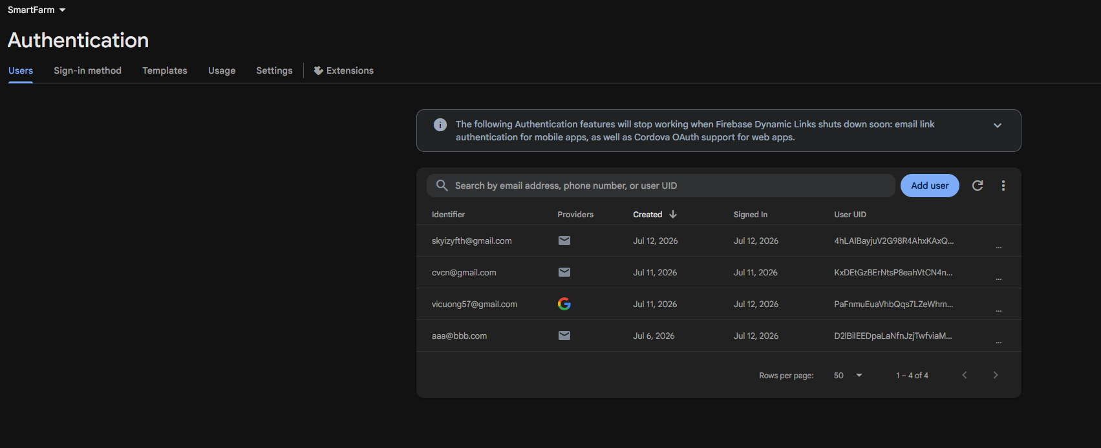
[picture p75: figure]

Describe in detail, the work that has been completed by each team member in this sprint only.

Name | Sprint 3 Work Completed
Chau Vi Cuong Nguyen | Implemented Firebase Authentication, Gmail Sign –In function Implemented function to Registration activity

Hoang Tran | Design feedback, login, sign up layout Implemented Alert Screen Update bottom navigation
Tuan Anh Pham | Implemented Setting, Main, Control Panel, Analytics & Graph Screen Implemented Runtime Permission
Truong An Nguyen | Finished toolbar menu Feedback DB Storage

Number of commits by each member for this sprint only.

Name | Number of commits
Chau Vi Cuong Nguyen | 15
Hoang Tran | 11
Tuan Anh Pham | 10
Truong An Nguyen | 12

## List of Sprint Goals

1. Complete Login + Registration with Firebase Authentication
2. Implement Gmail Sign-In
3. Add “Remember Me” functionality
4. Complete Feedback Screen with DB Storage
5. Update toolbar menu/ bottom navigation/ navigation drawer
6. Finish splash screen/ setting screen and user authentication

## Sprint Dashboard

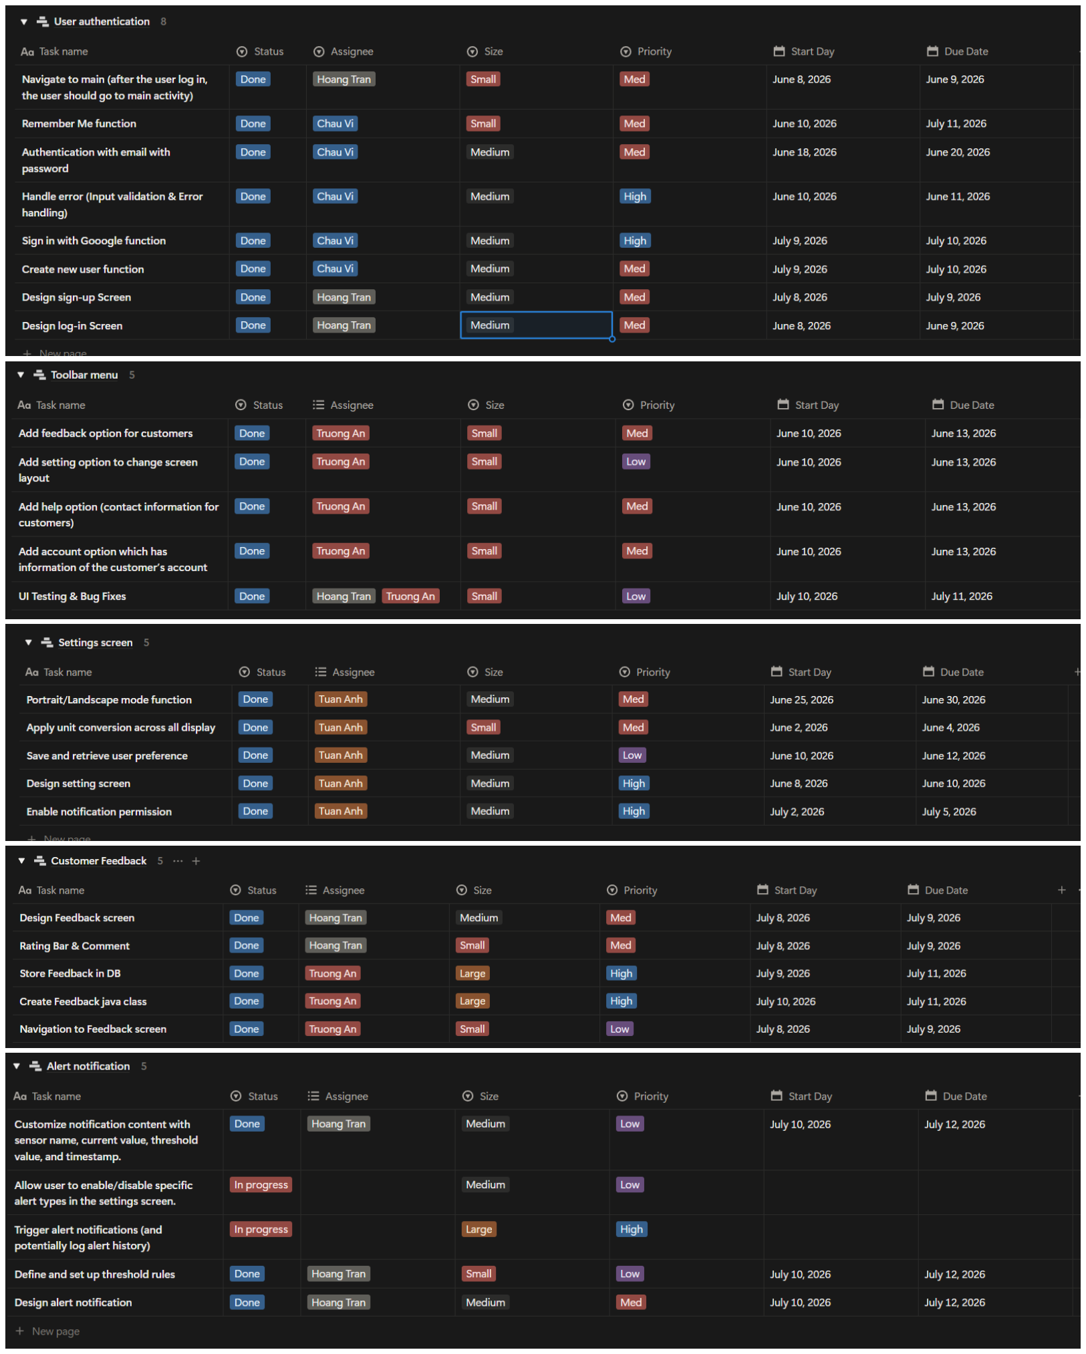
[picture p76: figure]

## Gantt Chart

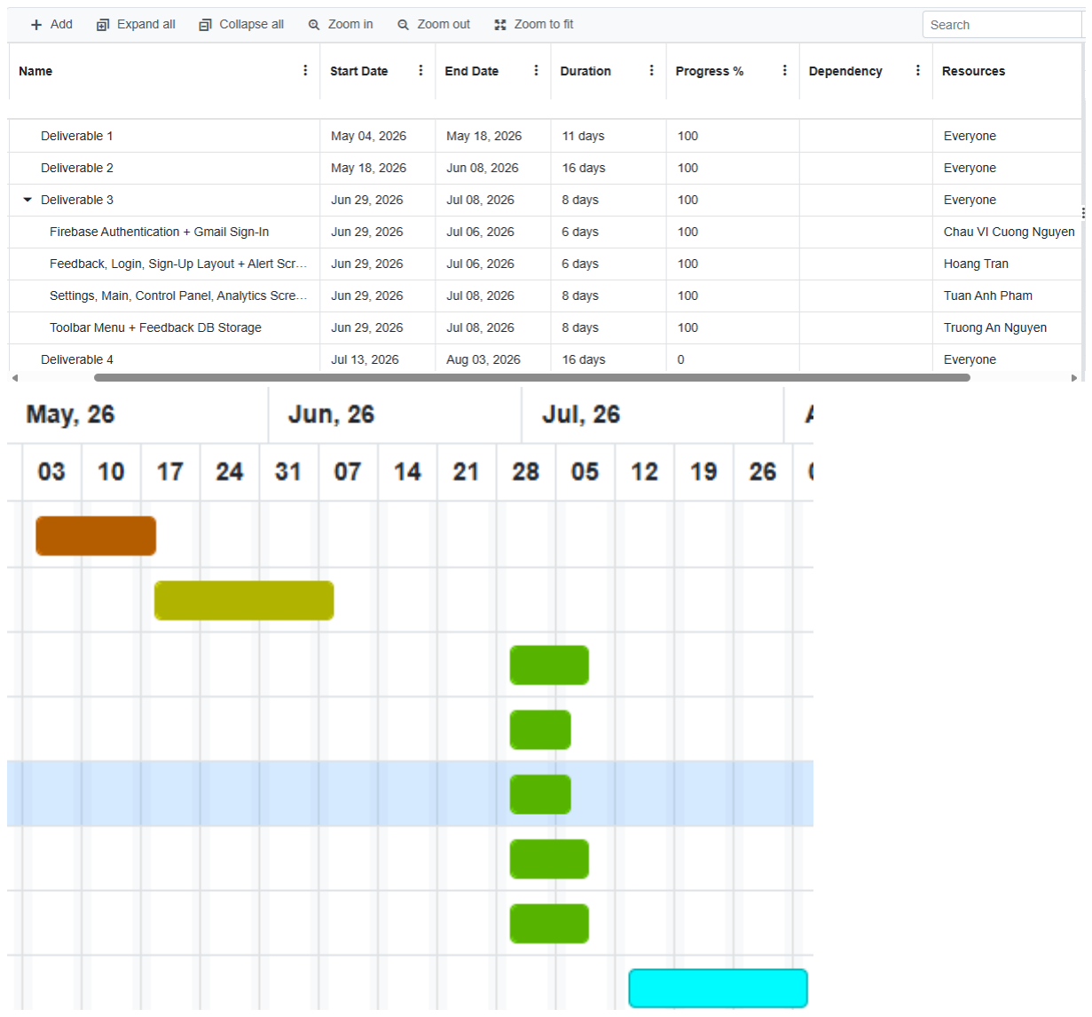
[picture p77: figure]

## Daily Stand-ups

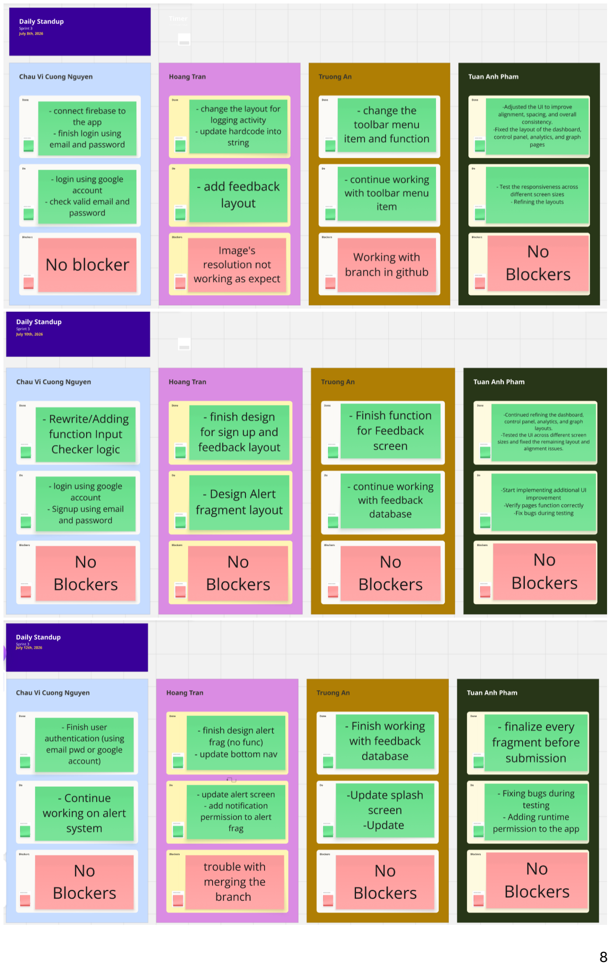
[picture p78: page 8]

## Design Principles and Design Patterns

Design Principles 1: Single Responsibility Principle (SRP)
A class should have only one reason to change.
Code evidence:
1. // LoginActivity.java
2. public class LoginActivity extends BaseActivity implements LoginController.LoginView {
3. private TextInputEditText etEmail, etPassword;
4. private MaterialButton btnLogin, btnSignup, btnGoogleSignIn;
5. private CheckBox cbRememberMe;
6. private LoginController loginController;
7.
8. @Override
9. protected void onCreate(Bundle savedInstanceState) {
10. super.onCreate(savedInstanceState);
11. setContentView(R.layout.activity_login);
12. loginController = new LoginController(this, this);
13. loginController.onStart();
14. initializeViews();
15. setupClickListeners();
16. }
17.
18. private void setupClickListeners() {
19. btnLogin.setOnClickListener(v -> {
20. String email = etEmail.getText().toString().trim();
21. String password = etPassword.getText().toString().trim();
22. boolean rememberMe = cbRememberMe.isChecked();
23. loginController.handleLogin(email, password, rememberMe);
24. });
25. }
26. }
27.
LoginActivity is responsible only for UI interactions, including but not limited to initializing views, setting up click listerners, displaying UI feedback, and navigating. This mean if the UI design changes, only LoginActivity needs modifications while the business logic remains untouched.
Design Principles 2: Dependency Inversion Principle (DIP)
High-level modules should not depend on low-level modules. Both should depend on abstractions (interfaces), not concrete implementations.
Code Evidence:
1. // LoginController.java - The high-level module depends on an interface
2. public class LoginController implements FirebaseAuthManager.AuthCallback {
3. private final LoginView view; // Depends on abstraction (interface) 4.
5. public interface LoginView {
6. void showLoading(boolean isLoading);
7. void showEmailError(String err);
8. void showPasswordError(String err);
9. void onLoginSuccess();
10. void onLoginFailure(String errorMessage);
11. void navigateToMain();
12. }
13. }
14.

LoginController (high-level module) depends on the LoginView interface (abstraction class), not on the concrete LoginActivity class. This allows the controller to work with any UI implementation without modification.
Design Pattern: Model – View – View Model (MVVM)
Separates the application into three interconnected components: Model (data logic), View (UI presentation), and Controller (mediator between Model and View).
1. public class LoginActivity extends BaseActivity implements LoginController.LoginView {
2. // UI elements
3. private TextInputEditText etEmail, etPassword;
4. private MaterialButton btnLogin, btnSignup, btnGoogleSignIn;
5. private CheckBox cbRememberMe;
6. private LoginController loginController;
7.
8. @Override
9. protected void onCreate(Bundle savedInstanceState) {
10. // Initialize views and controller
11. loginController = new LoginController(this, this);
12. initializeViews();
13. setupClickListeners();
14. }
15.
16. // View methods that update the UI
17. @Override
18. public void showEmailError(String err) {
19. tilEmail.setError(err);
20. }
21.
22. @Override
23. public void onLoginSuccess() {
24. Toast.makeText(this, R.string.login_success, Toast.LENGTH_SHORT).show();
25. navigateToMain();
26. }
27. }
28.
View (LoginActivity): Handles all UI rendering and user input. It implements LoginView interface to receive updates from the controller.
1. public class LoginController implements FirebaseAuthManager.AuthCallback {
2. private final FirebaseAuthManager authManager; // Model
3. | private final LoginView view; | // View
4. | private final InputChecker inputChecker; | // Model
5. private final LoginPreferences loginPreferences; // Model
6.
7. public void handleLogin(String email, String password, boolean rememberMe) {
8. // Validate input (business logic)
9. InputChecker.ValidationResult result = inputChecker.validateLogin(email, password);
10. if (!result.isValid()) {
11. // Update view with errors
12. view.showEmailError(result.getEmailError());
13. view.showPasswordError(result.getPasswordError());
14. return;
15. }
16.
17. // Coordinate authentication (business logic)
18. view.showLoading(true);
19. authManager.signInWithEmailAndPassword(email, password);
20. }
21.
22. // Callback from FirebaseAuthManager (Model)
23. @Override
24. public void onSuccess(FirebaseUser user) {

25. view.showLoading(false);
26. view.onLoginSuccess(); // Update view
27. }
28. }
29.
Controller/Presenter (LoginController): Acts as the middleman, processing user actions, executing business logic, and updating the view through the interface.
1. // FirebaseAuthManager.java - Data/authentication model
2. public class FirebaseAuthManager {
3. private final FirebaseAuth mAuth;
4.
5. public void signInWithEmailAndPassword(String email, String password) {
6. mAuth.signInWithEmailAndPassword(email, password)
7. .addOnCompleteListener(task -> {
8. if (task.isSuccessful()) {
9. callback.onSuccess(mAuth.getCurrentUser());
10. } else {
11. callback.onFailure(task.getException().getMessage());
12. }
13. });
14. }
15. }
16.
17. // InputChecker.java - Validation model
18. public class InputChecker {
19. public ValidationResult validateLogin(String email, String password) {
20. // Business logic for validation
21. Map<String, String> errors = new HashMap<>();
22. String emailError = validateEmail(email);
23. if (emailError != null) errors.put(FIELD_EMAIL, emailError);
24. // ... more validation
25. return new ValidationResult(errors.isEmpty(), errors);
26. }
27. }
28.
29. // LoginPreferences.java - Data persistence model
30. public class LoginPreferences {
31. public void setRememberMe(boolean rememberMe) {
32. editor.putBoolean(KEY_REMEMBER_ME, rememberMe).apply();
33. }
34. }
35.
Model (FirebaseAuthManager, InputChecker, LoginPreferences): Manages data, authentication, validation, and persistence logic.

## Runtime Permission

Implemented permission:

### 1. Notification Permission

(android.permission.POST_NOTIFICATIONS)

The application requests notification permission to allow the system to display alerts and updates to users. This feature is used to notify users about important farm events, such as sensor warnings, abnormal temperature levels, or device status changes.

The permission is declared in AndroidManifest.xml:

<uses-permission
android:name="android.permission.POST_NOTIFICATIONS"/>

At runtime, the application checks whether notification permission has been granted. If permission is not granted, the application requests access from the user. Once approved, the application can send notifications.

### 2. Network State Permission

(android.permission.ACCESS_NETWORK_STATE)

The application uses network state permission to check the current network connection status. This allows the application to determine whether the device is connected to a network before communicating with external smart farm devices or cloud services.

The permission is declared in AndroidManifest.xml:

<uses-permission
android:name="android.permission.ACCESS_NETWORK_STATE"/>

This permission does not require a runtime request because Android grants it automatically during installation.

## Two new main functionalities

Main Functionality 1: Real-Time Farm Monitoring Dashboard

The first implemented feature is the Farm Monitoring Dashboard.

This feature allows users to monitor the current condition of the smart farm through a single interface. The dashboard displays:

- ESP32 connection status
- Temperature information
- Soil moisture level
- Light level
- Sensor warnings and alerts

The dashboard provides users with a quick overview of farm conditions and helps identify problems, such as unsafe temperature levels.

(Screenshot: Dashboard screen)

Comment:

The dashboard successfully provides a centralized view of sensor data and device status. The visual indicators and organized layout make it easier for users to monitor the farm environment and quickly respond to abnormal conditions.

Main Functionality 2: Device Control Panel

The second implemented feature is the Device Control Panel.

This feature allows users to manually control connected farm devices:

- Irrigation pump
- Cooling fan
- Grow light
- Automatic mode

Users can turn devices ON or OFF using switches. The application updates the status display and provides feedback messages when a control action is performed.

## Customer Feedback in the DB

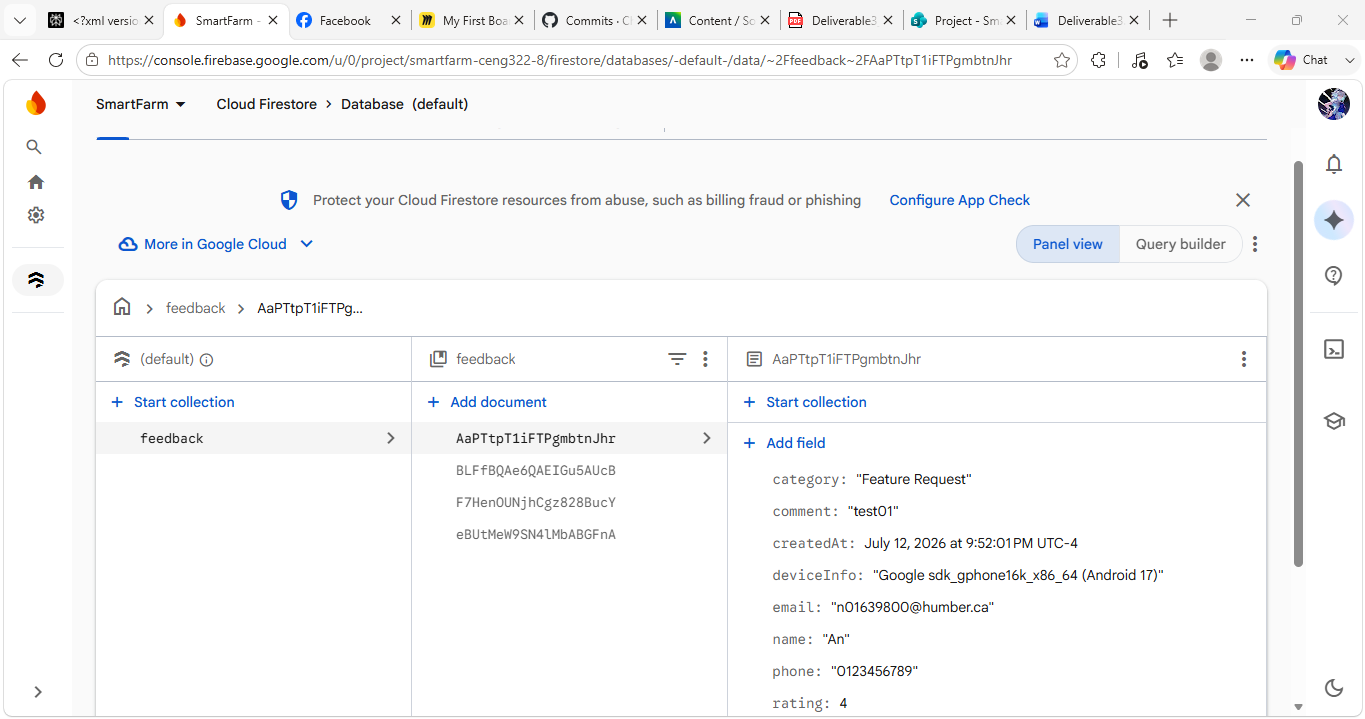
[picture p79: figure]

Screenshot showing clearly the data transmitted from Feedback screen, and store to DB

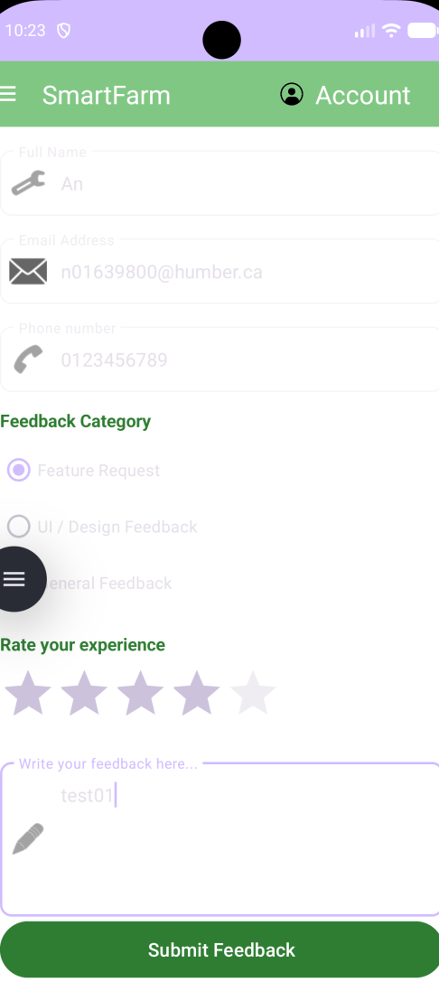
[picture p80: figure]

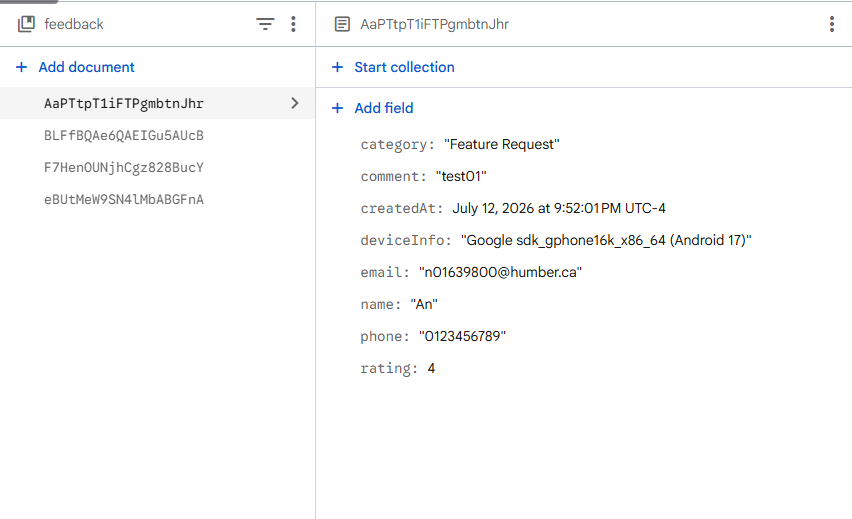
[picture p81: figure]

How the data from the Customer Feedback Screen stored in the DB?
