TuanAnhPham8459/SmartFarm/SmartFarmModule/src/main/ic_launcher-playstore.png

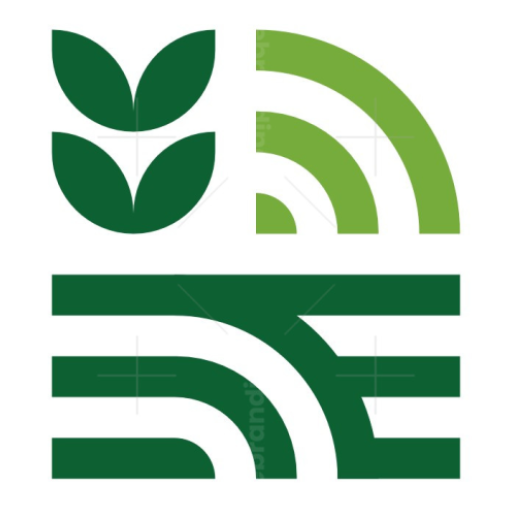
SmartFarmModule/src/main/ic_launcher-playstore.png
