TuanAnhPham8459/SmartFarm/hardware/Smart Farm - myList.xlsx

Country of Origin may be different at time of shipment.
The HTSUS and ECCN information shown is for informational purposes only and is not a representation or warranty as to the accuracy or reliability of these classifications. All information is provided "as is" and is subject to change without notice. Any use made of the information provided is without recourse to Digi-Key and at the user's risk.
Index | Manufacturer Part Number | Manufacturer Name | Description | Lead Time | Availability | Stock Status | Attrition % | Requested Quantity 1 | Pack Quantity 1 | Pack Type 1 | Digi-Key Part Number 1 | Unit Price 1 | Extended Price 1 | Minimum Order Quantity 1 | Customer Reference | Requested Part Number | Lead Weeks | Datasheet | Reference Designator | US Import Tariff | Note | Part Status | RoHS Status | REACH Status | Moisture Sensitivity Level (MSL) | ECCN | HTSUS | Country of Origin | Environmental Information | Original Part numbers | Unit of Measure | Image | Product Notes
1 | 1979 | Adafruit Industries LLC | STACKING HEADER RASPBERRY PI | 1 expected in stock on 26-May-2026 | 997 | In Stock |  | 1 | 1 | Bulk | 1528-1783-ND | 2.95000 | $2.95 | 1 |  | 1528-1783-ND | 18 | https://mm.digikey.com/Volume0/opasdata/d220001/medias/docus/2342/1979_Web.pdf |  | N/A |  | Active | ROHS3 Compliant | Vendor Undefined | 1 (Unlimited) | EAR99 | 8536.69.4040 | China |  | 1528-1783-ND | Each | https://mm.digikey.com/Volume0/opasdata/d220001/medias/images/2319/MFG_1979.jpg
2 | 110990037 | Seeed Technology Co., Ltd | GROVE 2MM 4PIN R/A CONN 10PACK |  | 2,782 | In Stock |  | 1 | 1 | Bulk | 1597-1083-ND | 1.70000 | $1.70 | 1 |  | 1597-1083-ND | 7 | https://mm.digikey.com/Volume0/opasdata/d220001/medias/docus/698/110990037_Web.pdf |  | N/A |  | Active | RoHS Compliant |  | 1 (Unlimited) | EAR99 | 8536.69.4040 | - |  | 1597-1083-ND | Each | https://mm.digikey.com/Volume0/opasdata/d220001/medias/images/2539/MFG_110990037.JPG
3 | 4528 | Adafruit Industries LLC | 4-PIN STEMMA/GROVE - QT/QWIIC 4" | 1 past due; estimated in-stock on 20-May-2026 | 0 | Normally Stocking |  | 1 | 1 | Bulk | 1528-4528-ND | 1.95000 | $1.95 | 1 |  | 1528-4528-ND | 18 | https://mm.digikey.com/Volume0/opasdata/d220001/medias/docus/55/4528_Web.pdf |  | N/A |  | Active | ROHS3 Compliant | Vendor Undefined | 1 (Unlimited) | EAR99 | 8544.42.9090 | United States |  | 1528-4528-ND | Each | https://mm.digikey.com/Volume0/opasdata/d220001/medias/images/840/4528.jpg
4 | 22726 | SparkFun Electronics | FLEXIBLE QWIIC CABLE - FEMALE JU |  | 136 | In Stock |  | 1 | 1 | Box | 1568-22726-ND | 1.99000 | $1.99 | 1 |  | 1568-22726-ND | 12 |  |  | N/A |  | Active | ROHS3 Compliant |  | 1 (Unlimited) | EAR99 | 8544.42.9090 | - |  | 1568-22726-ND | Each | https://mm.digikey.com/Volume0/opasdata/d220001/medias/images/5543/MFG_CAB-22726.jpg
5 | 50M025045I016 | Essentra Components | MACH SCREW FLAT PHIL M2.5X0.45 |  | 1,138 | In Stock |  | 4 | 4 | Bulk | 145-50M025045I016-ND | 0.14000 | $0.56 | 1 |  | 145-50M025045I016-ND | 8 | https://mm.digikey.com/Volume0/opasdata/d220001/medias/docus/5732/50M025045I016.pdf |  | N/A |  | Active | ROHS3 Compliant | REACH Unaffected | Not Applicable | EAR99 | 3926.90.9989 | United States |  | 145-50M025045I016-ND | Each | https://mm.digikey.com/Volume0/opasdata/d220001/medias/images/54/MFG_50M080125I050.jpg
6 | 5384 | Adafruit Industries LLC | STEMMA QT/QWIIC CABLE 300MM |  | 3,113 | In Stock |  | 1 | 1 | Bulk | 1528-5384-ND | 1.25000 | $1.25 | 1 |  | 1528-5384-ND | 18 | https://cdn-shop.adafruit.com/product-files/5384/5384_CBH-C16997-001.pdf |  | N/A |  | Active | ROHS3 Compliant |  | 1 (Unlimited) | EAR99 | 8544.42.9090 | China |  | 1528-5384-ND | Each | https://mm.digikey.com/Volume0/opasdata/d220001/medias/images/4066/MFG_5384.jpg
7 | 971160151 | Würth Elektronik | HEX STANDOFF M2.5X0.45 STL 16MM | 4 past due; estimated in-stock on 19-May-2026 | 0 | Normally Stocking |  | 4 | 4 | Bulk | 732-10422-ND | 0.73000 | $2.92 | 1 |  | 732-10422-ND | 26 | https://mm.digikey.com/Volume0/opasdata/d220001/medias/docus/6156/971xx0xx1.pdf |  | N/A |  | Active | ROHS3 Compliant | REACH Affected | Not Applicable | EAR99 | 7318.19.0000 | Germany | https://mm.digikey.com/Volume0/opasdata/d220001/medias/docus/744/Certificate_of_Compliance_ROHS.pdf | 732-10422-ND | Each | https://mm.digikey.com/Volume0/opasdata/d220001/derivates/6/003/243/903/MFG_971160151_web%28640x640%29.jpg
8 | 4162 | Adafruit Industries LLC | VEML7700 I2C LUX SENSOR EVAL BRD |  | 288 | In Stock |  | 1 | 1 | Bulk | 1528-2891-ND | 4.95000 | $4.95 | 1 |  | 1528-2891-ND | 18 | https://cdn-learn.adafruit.com/downloads/pdf/adafruit-veml7700.pdf |  | N/A |  | Active | ROHS3 Compliant | Vendor Undefined | 1 (Unlimited) | EAR99 | 8473.30.1180 | United States |  | 1528-2891-ND | Each | https://mm.digikey.com/Volume0/opasdata/d220001/medias/images/4846/MFG_1528_4162.jpg
9 | 22638 | SparkFun Electronics | SPARKFUN TRISTIMULUS COLOR SENSOR |  | 21 | In Stock |  | 1 | 1 | Box | 1568-22638-ND | 13.50000 | $13.50 | 1 |  | 1568-22638-ND | 12 |  |  | N/A |  | Active | Unknown | Vendor Undefined | 1 (Unlimited) | EAR99 | 9027.50.4060 | United States |  | 1568-22638-ND | Each | https://mm.digikey.com/Volume0/opasdata/d220001/derivates/6/003/220/822/MFG_SEN-22638_web%28640x640%29.jpg
10 | 18345 | SparkFun Electronics | QWIIC AIR QUALITY SENSOR SGP40 |  | 1 | In Stock |  | 1 | 1 | Bulk | 1568-18345-ND | 18.95000 | $18.95 | 1 |  | 1568-18345-ND | 12 | https://cdn.sparkfun.com/assets/learn_tutorials/1/7/9/2/SparkFun_Qwiic_SGP40-Dimensions.png |  | N/A |  | Active | Unknown | REACH Unaffected | 1 (Unlimited) | EAR99 | 9027.10.2000 | United States |  | 1568-18345-ND | Each | https://mm.digikey.com/Volume0/opasdata/d220001/medias/images/4039/MFG_SEN-18345.jpg
11 | 3531 | Adafruit Industries LLC | ADAFRUIT 128X64 OLED BONNET FOR |  | 15 | In Stock |  | 1 | 1 | Bulk | 1528-2320-ND | 22.50000 | $22.50 | 1 |  | 1528-2320-ND | 18 | https://cdn-learn.adafruit.com/downloads/pdf/adafruit-128x64-oled-bonnet-for-raspberry-pi.pdf |  | N/A |  | Active | ROHS3 Compliant | Vendor Undefined | 1 (Unlimited) | EAR99 | 8531.20.0020 | United States |  | 1528-2320-ND | Each | https://mm.digikey.com/Volume0/opasdata/d220001/medias/images/4848/1528_3531.JPG
