TuanAnhPham8459/SmartFarm/hardware/SmartFarm_poster.pdf

## SMART FARM Real-time greenhouse monitoring, alerts and control

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

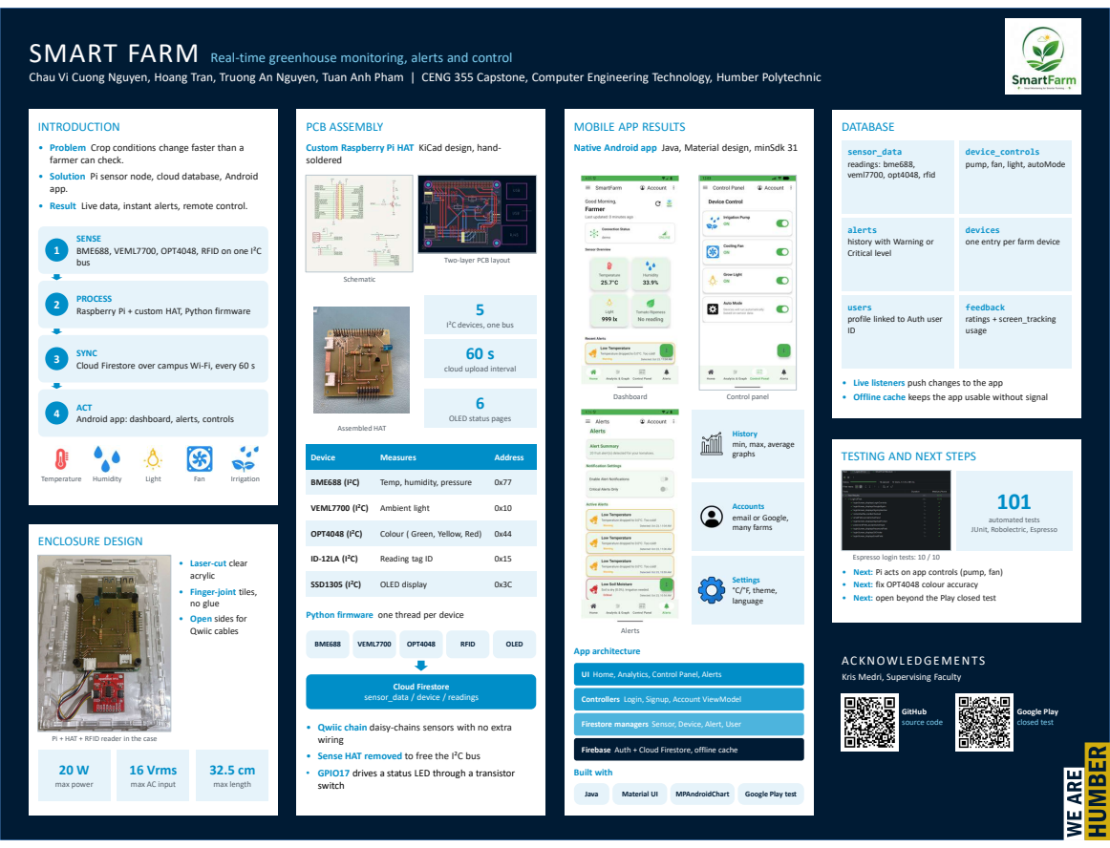
[picture p83: page 1]
ENCLOSURE DESIGN; INTRODUCTION; PCB ASSEMBLY; MOBILE APP RESULTS; DATABASE; Temperature Humidity; Light; Fan; Irrigation; Qwiic cables; max power; 16 Vrms; max length; Schematic; Two-layer PCB layout Assembled HAT; OLED status pages Device; Measures; Address BME688 (I; Temp, humidity, pressure; Python firmware one thread per device BME688; VEML7700; OPT4048; RFID; OLED; Cloud Firestore; Dashboard; Control panel; Alerts; many farms; Settings °C/°F, theme, language; Built with; Java; Material UI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

Custom Raspberry Pi HAT KiCad design, hand-
soldered

Native Android app Java, Material design, minSdk 31

sensor_data readings: bme688, veml7700, opt4048, rfid | device_controls pump, fan, light, autoMode

app. • Result Live data, instant alerts, remote control.

alerts history with Warning or Critical level | devices one entry per farm device users

SENSE
BME688, VEML7700, OPT4048, RFID on one I²C
bus

2 PROCESS
Raspberry Pi + custom HAT, Python firmware

ratings + screen_tracking usage • Live listeners push changes to the app

profile linked to Auth user ID

I²C devices, one bus

SYNC
Cloud Firestore over campus Wi-Fi, every 60 s

cloud upload interval

• Offline cache keeps the app usable without signal

4 ACT
Android app: dashboard, alerts, controls

History
min, max, average
graphs Accounts email or Google,

TESTING AND NEXT STEPS

VEML7700 (I Ambient light | 0x10 ²C)

automated tests
JUnit, Robolectric, Espresso

OPT4048 (I Colour ( Green, Yellow, Red) | 0x44 ²C)

• Laser-cut clear
acrylic • Finger-joint tiles,

ID-12LA (I Reading tag ID | 0x15 ²C)

Espresso login tests: 10 / 10
• Next: Pi acts on app controls (pump, fan) • Next: fix OPT4048 colour accuracy • Next: open beyond the Play closed test

SSD1305 (I OLED display | 0x3C ²C)

no glue • Open sides for

App architecture UI Home, Analytics, Control Panel, Alerts Controllers Login, Signup, Account ViewModel

Kris Medri, Supervising Faculty GitHub

sensor_data / device / readings • Qwiic chain daisy-chains sensors with no extra

Firestore managers Sensor, Device, Alert, User Firebase Auth + Cloud Firestore, offline cache

Pi + HAT + RFID reader in the case

wiring • Sense HAT removed to free the I²C bus

• GPIO17 drives a status LED through a transistor
switch

max AC input
