TuanAnhPham8459/SmartFarm/hardware/pcb/CVCuongNguyen2026-06-08.kicad_pcb

## KiCad design hardware/pcb/CVCuongNguyen2026-06-08.kicad_pcb (2026-11-10)

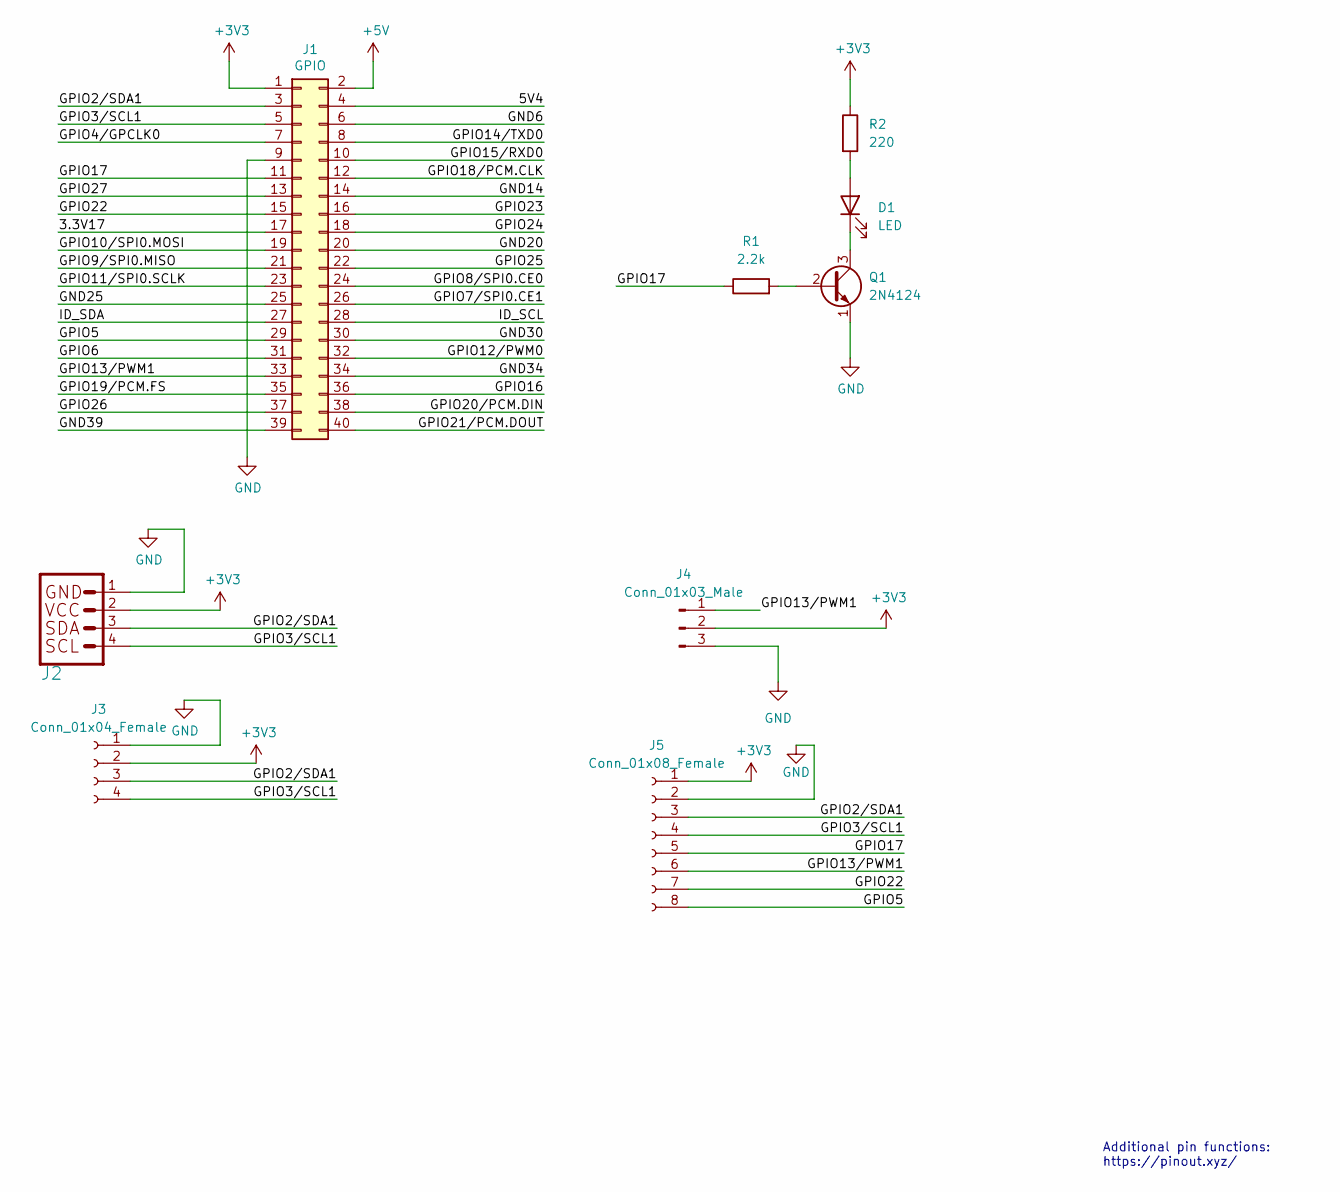
[picture p84: schematic CVCuongNguyen2026-06-08.kicad_sch]

Parts:
D1: LED; LED_D5.0mm_Horizontal_O1.27mm_Z3.0mm
J1: GPIO; PinSocket_2x20_P2.54mm_Vertical
J2: Qwiic Right Angle; PinSocket_1x04_P2.00mm_Horizontal
J3: Conn_01x04_Female; PinSocket_1x04_P2.54mm_Horizontal
J4: Conn_01x03_Male; PinHeader_1x03_P2.54mm_Horizontal
J5: Conn_01x08_Female; PinSocket_1x08_P2.54mm_Horizontal
Q1: 2N4124; TO-92_Inline_Wide
R1: 2.2k; R_Axial_DIN0207_L6.3mm_D2.5mm_P15.24mm_Horizontal
R2: 220; R_Axial_DIN0207_L6.3mm_D2.5mm_P15.24mm_Horizontal

Connections:
+3V3: J1.1, J2.2, J3.2, J4.2, J5.1, R2.1
+5V: J1.2
/3.3V17: J1.17
/5V4: J1.4
/GND6: J1.6
/GND14: J1.14
/GND20: J1.20
/GND25: J1.25
/GND30: J1.30
/GND34: J1.34
/GND39: J1.39
/GPIO2/SDA1: J1.3, J2.3, J3.3, J5.3
/GPIO3/SCL1: J1.5, J2.4, J3.4, J5.4
/GPIO4/GPCLK0: J1.7
/GPIO5: J1.29, J5.8
/GPIO6: J1.31
/GPIO7/SPI0.CE1: J1.26
/GPIO8/SPI0.CE0: J1.24
/GPIO9/SPI0.MISO: J1.21
/GPIO10/SPI0.MOSI: J1.19
/GPIO11/SPI0.SCLK: J1.23
/GPIO12/PWM0: J1.32
/GPIO13/PWM1: J1.33, J4.1, J5.6
/GPIO14/TXD0: J1.8
/GPIO15/RXD0: J1.10
/GPIO16: J1.36
/GPIO17: J1.11, J5.5, R1.1
/GPIO18/PCM.CLK: J1.12
/GPIO19/PCM.FS: J1.35
/GPIO20/PCM.DIN: J1.38
/GPIO21/PCM.DOUT: J1.40
/GPIO22: J1.15, J5.7
/GPIO23: J1.16
/GPIO24: J1.18
/GPIO25: J1.22
/GPIO26: J1.37
/GPIO27: J1.13
/ID_SCL: J1.28
/ID_SDA: J1.27
GND: J1.9, J2.1, J3.1, J4.3, J5.2, Q1.1 (E)
unnamed: D1.2 (A), R2.2
unnamed: D1.1 (K), Q1.3 (C)
unnamed: Q1.2 (B), R1.2

Notes on the sheet:
Additional pin functions: https://pinout.xyz/

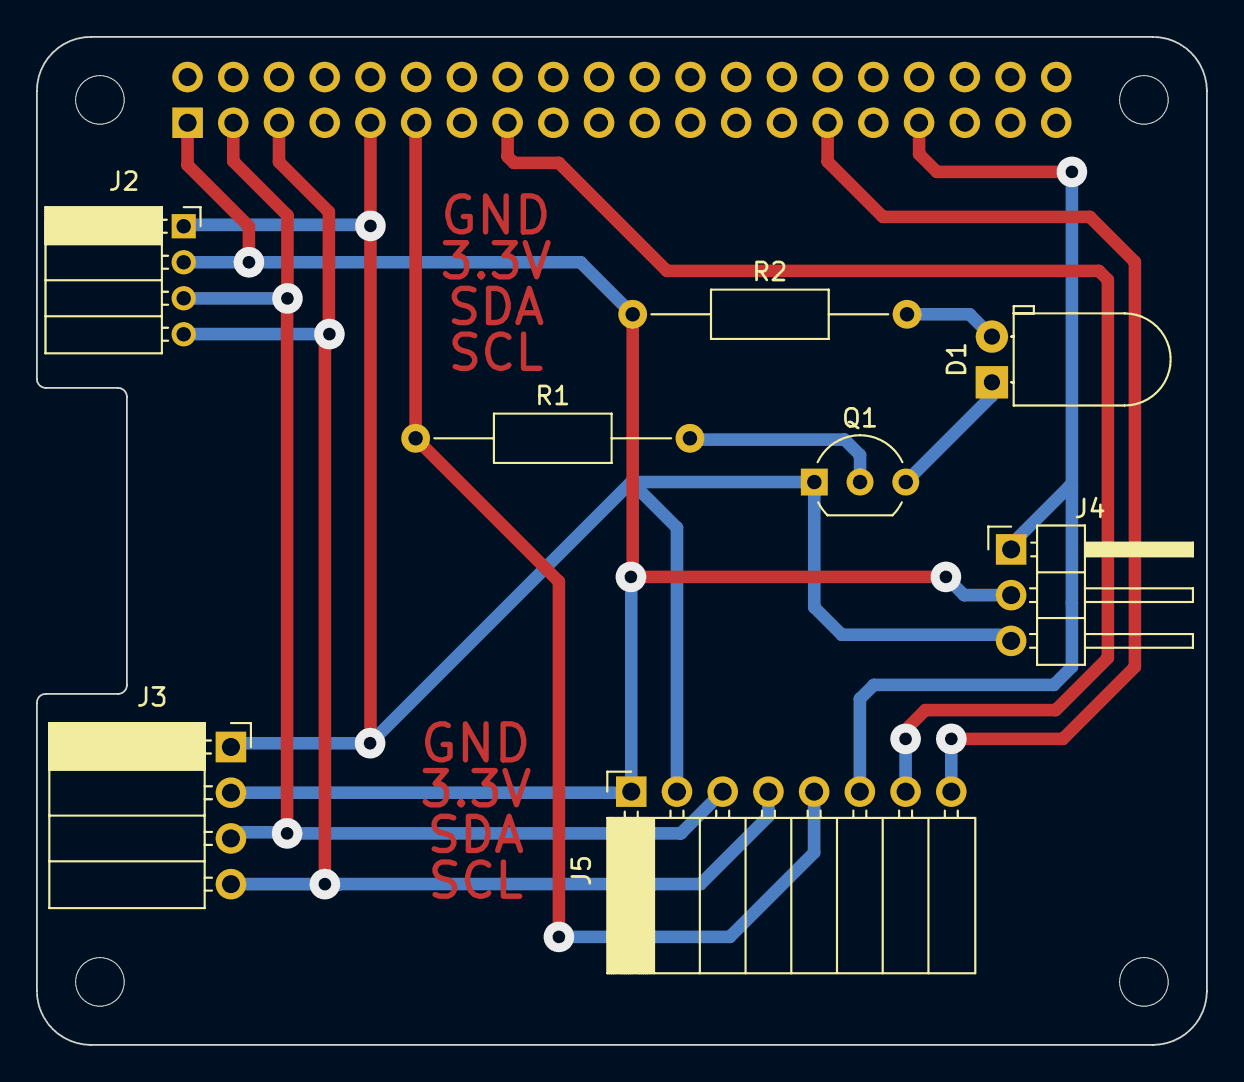
[picture p85: board CVCuongNguyen2026-06-08.kicad_pcb from above]

Board: 2 copper layers, 65.0 x 56.0 mm, 13 parts (1 on the bottom side), 11 nets.

Other parts of the board:
MH1, MH2, MH3, MH4: MountingHole_2.7mm_M2.5
